SeaGlide/Test/Lessons/Buoyancy/Glider Full of Water 2.jpg

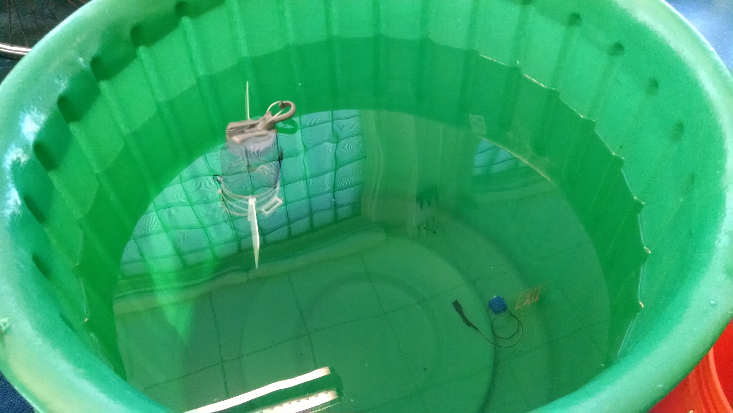
Lessons/Buoyancy/Glider Full of Water 2.jpg
