SeaGlide/Test/Lessons/Buoyancy/Glider Full of Water.jpg

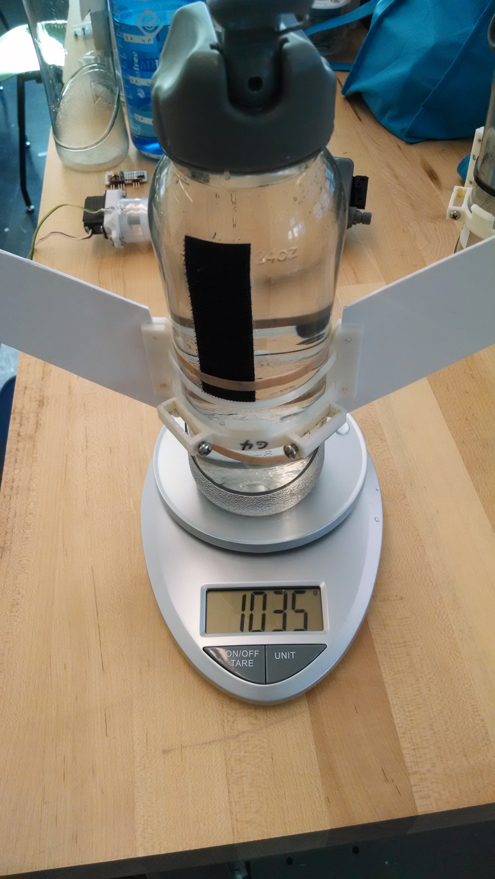
Lessons/Buoyancy/Glider Full of Water.jpg
