SeaGlide/Test/Firmware/Sensor Firmware in : Sensors.rtf

Firmware for sensors pack in / Sensors / ReadTMP102Press6250andWritetoOpenLog
Firmware for sensors attached to glider controller in / Sensors / Sensors in Bottle
