SeaGlide/Test/Firmware/other firmware/Other Firmeares Discription.rtf

SeaGlideV0_9_1
Previous version of the SeaGlide Firmware

SeaGlideV0_9_2
The latest version of the SeaGlide Firmware

SeaGlideV0_9_2Rdr
Variant of 0.9.2 with rudder control via IR Remote. first pause then R & L Arrows move rudder

SeaGlideV0_9_2S
tem102 & Pressure sensors attached and logging data to serial port at regular interval

SimpleGlider2014_IR_mEncoder
2014 SeaGlide firmware with experimental magnetic encoder. borrow code from here to reintegrate magnetic encoder into current version. (it’s not using interrupts, just polling for the pulses)

SimpleGlider2014_IR_mEncoderBB
Breadboard version with different pin assignments
