SeaGlide/Test/Build Instructions/7- Bottle Prep and Ballasting+Wing Design.pdf

# Bottle Prep and Ballasting

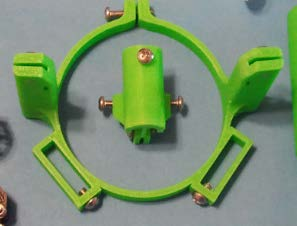
[picture p3: figure]
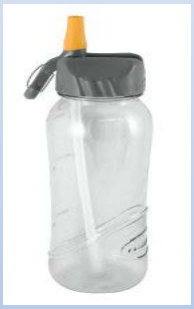
[picture p4: figure]
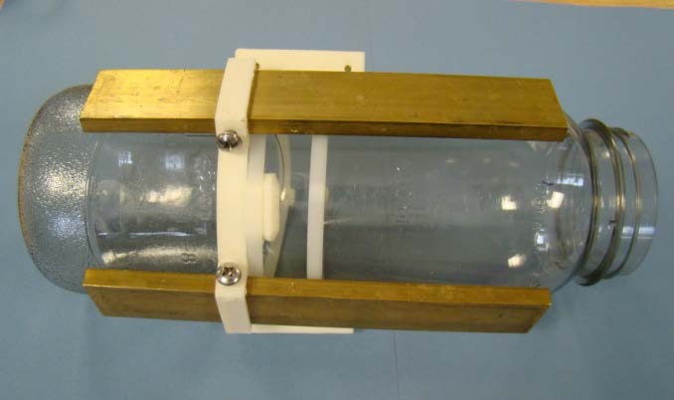
[picture p5: figure]
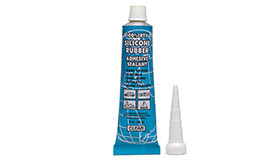
[picture p6: figure]

Parts and supplies include the bottle (1), wing yoke and rudder mount with zip ties (2), brass ballast weights and Dual Lock (3), and silicone sealant (4).

2

3

4

1

## Remove Foam Nozzle and Straws

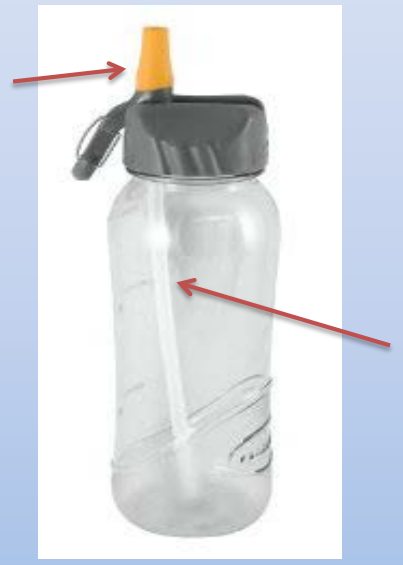
[picture p7: figure]

Remove foam nozzle from cap and plastic straws from inside the bottle.

Foam Nozzle

Plastic Straw

## Prepare Cap for Rudder Mount

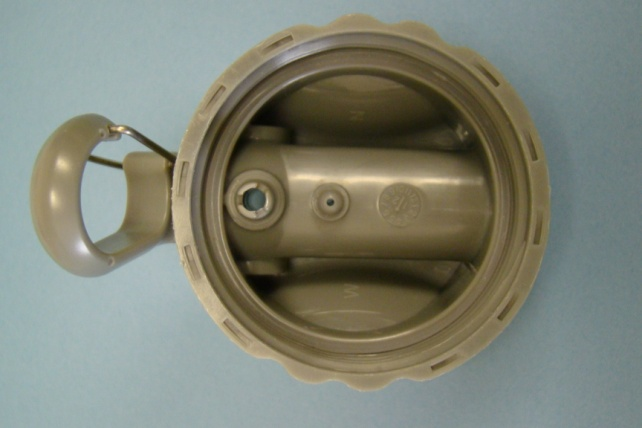
[picture p8: figure]
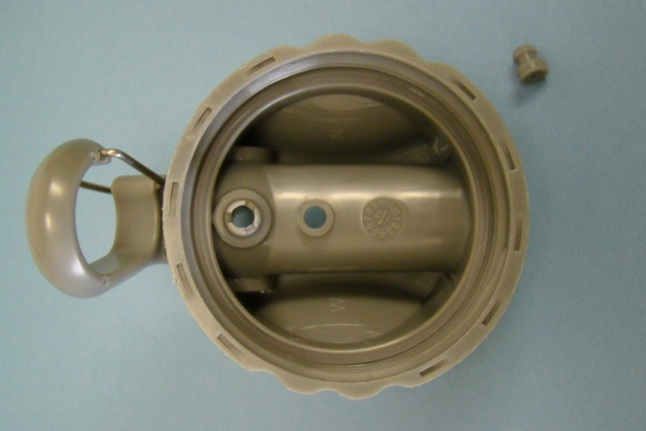
[picture p9: figure]

Remove Air Hole Plug from Cap

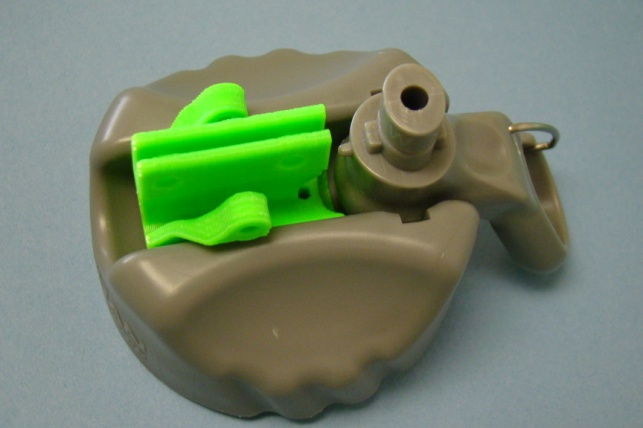
[picture p10: figure]

Test fit rudder mount by aligning screw hole with air hole in cap.

# Secure Rudder Mount

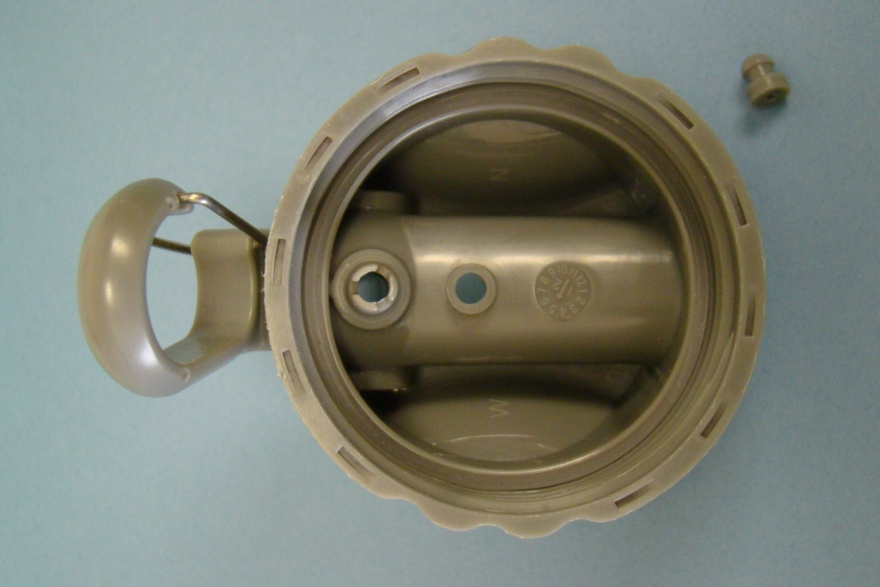
[picture p11: figure]
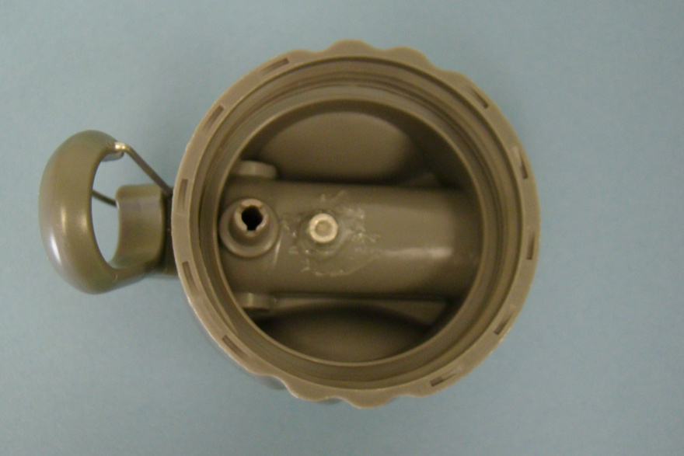
[picture p12: figure]

Apply silicone sealant to air hole opening and drinking spout slot. Position rudder mount and secure from inside with screw provided.

Apply Silicone Sealant | Attach Rudder Mount

# Seal Inside of Cap

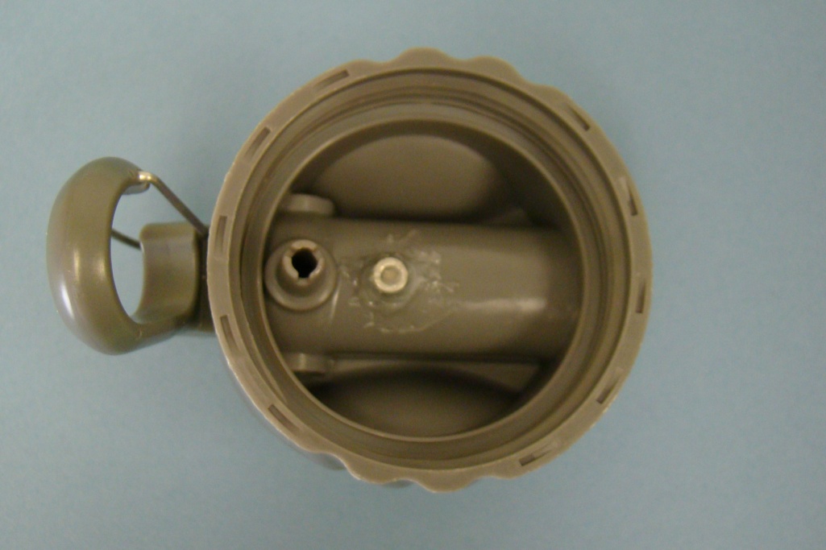
[picture p13: figure]

Apply silicone around and over screw head inside cap to further seal opening and prevent electrical short circuits.

# Attach Wing Yoke

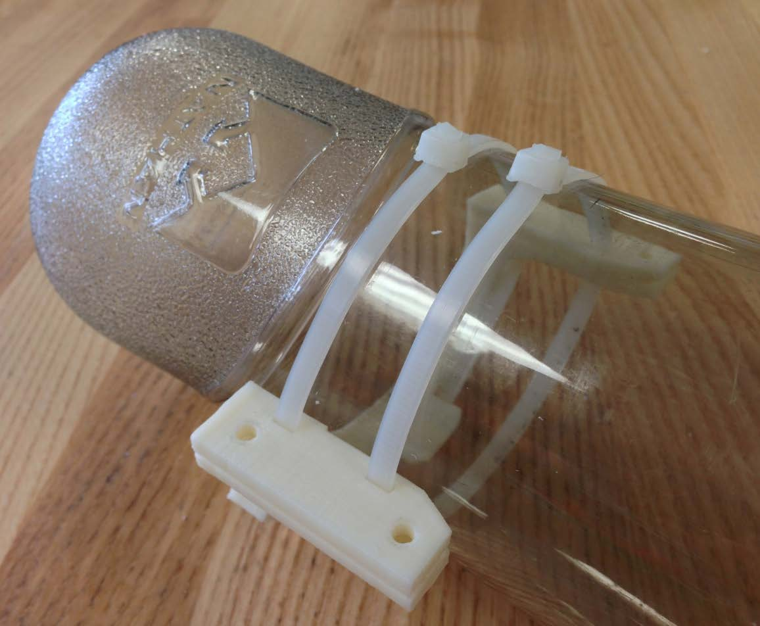
[picture p14: figure]

Position wing yoke on bottle and secure with two zip ties provided.

# Add Ballast to Wing Yoke

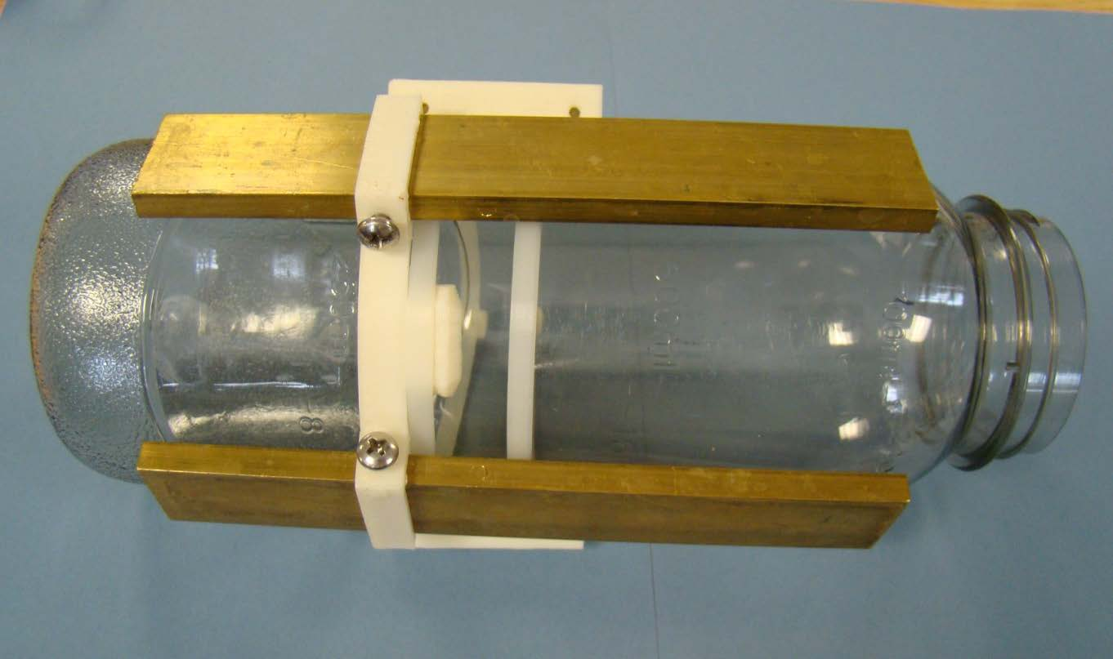
[picture p15: figure]

Slide two 6” bars of brass ballast weight through slots in wing yoke. Secure with screws provided.

# Add Fine Ballast

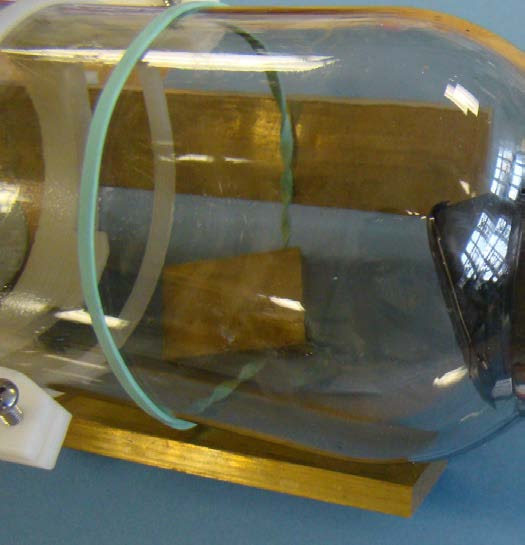
[picture p16: figure]

Stick Dual Lock on bottle between larger brass bars. Apply Dual Lock to a brass weight. This can be positioned anywhere on the bottle’s Dual Lock for finer ballasting.

# Basic Wing Design

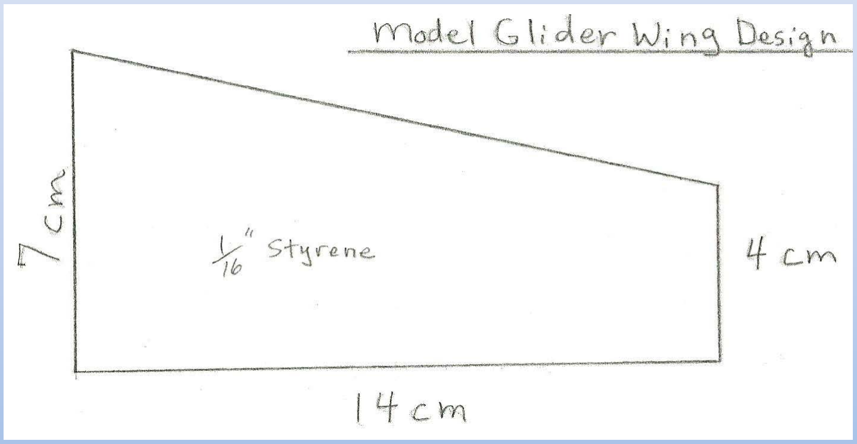
[picture p17: figure]

It’s best to create your own wing design based on research, however this is a basic design that works. You’ll need two wings that can be cut from 1/16th styrene.

# Basic Rudder Design

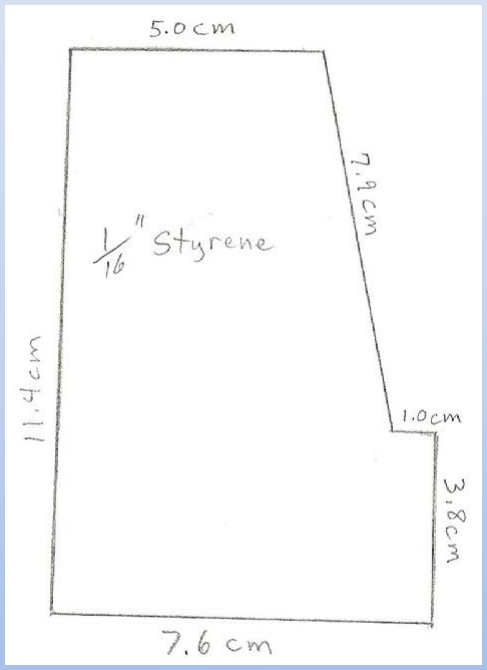
[picture p18: figure]

It’s best to create your own rudder design based on research, however this is a basic design that works. You’ll need one rudder that can be cut from 1/16th styrene.

# Test Fit Wings and Rudder

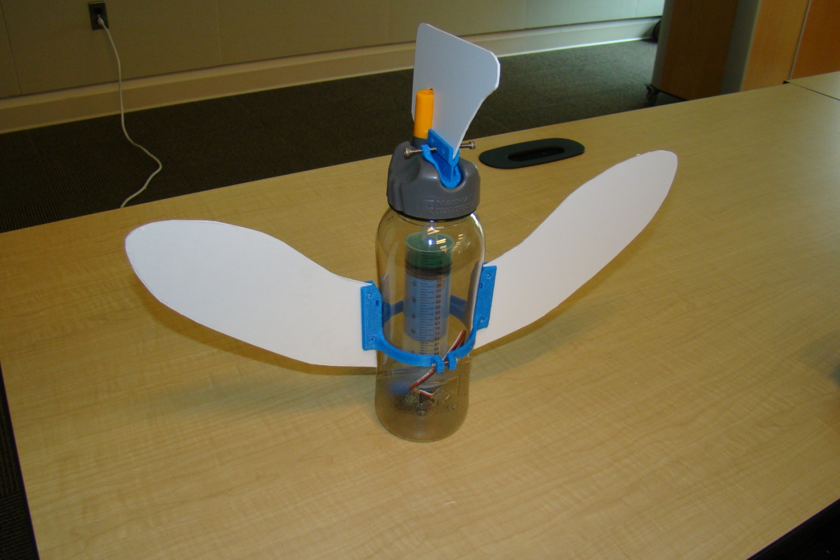
[picture p19: figure]

Fit wings into wing yoke and rudder into rudder mount. Mark drill holes and remove for drilling.

## Drill Wings and Rudder Mounting Holes

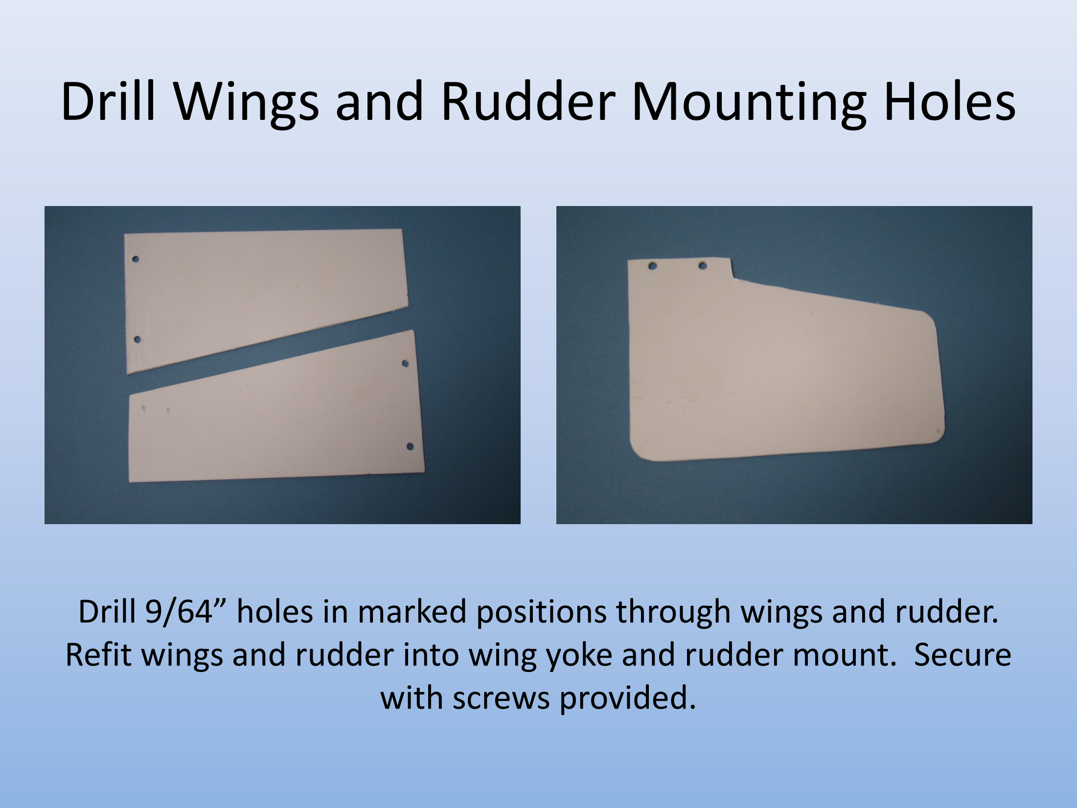
[picture p20: page 12]

Drill 9/64” holes in marked positions through wings and rudder. Refit wings and rudder into wing yoke and rudder mount. Secure with screws provided.
