SeaGlide/Test/Lessons/Arduino lessons/_1.1_TrafficLight/Traffic Light simple.png

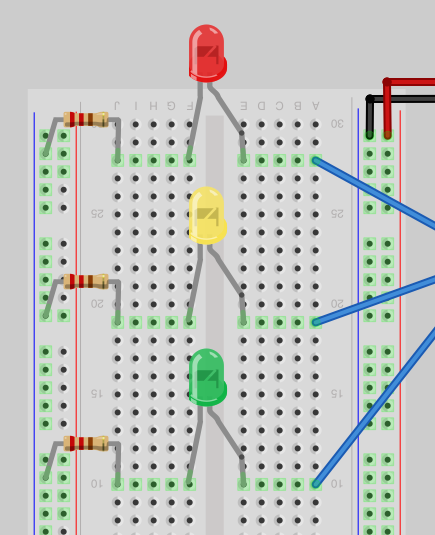
Lessons/Arduino lessons/_1.1_TrafficLight/Traffic Light simple.png
