SeaGlide/Test/Lessons/Arduino lessons/_1.2_TrafficLightWithSensorChallange/Advanced traffic Light challange.png

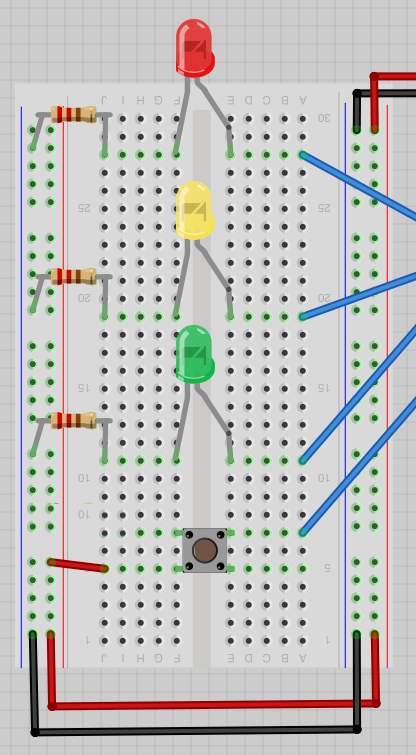
Lessons/Arduino lessons/_1.2_TrafficLightWithSensorChallange/Advanced traffic Light challange.png
