SeaGlide/Test/Lessons/Arduino lessons/_1_Blink/1 blink.png

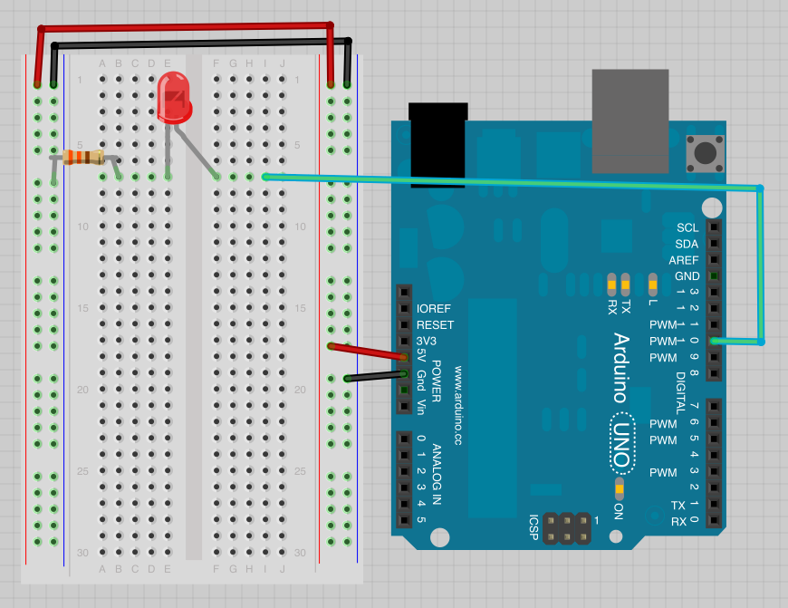
Lessons/Arduino lessons/_1_Blink/1 blink.png
