SeaGlide/Test/Lessons/Arduino lessons/_2.5_potFadeSerialMethod/FlexSensor.png

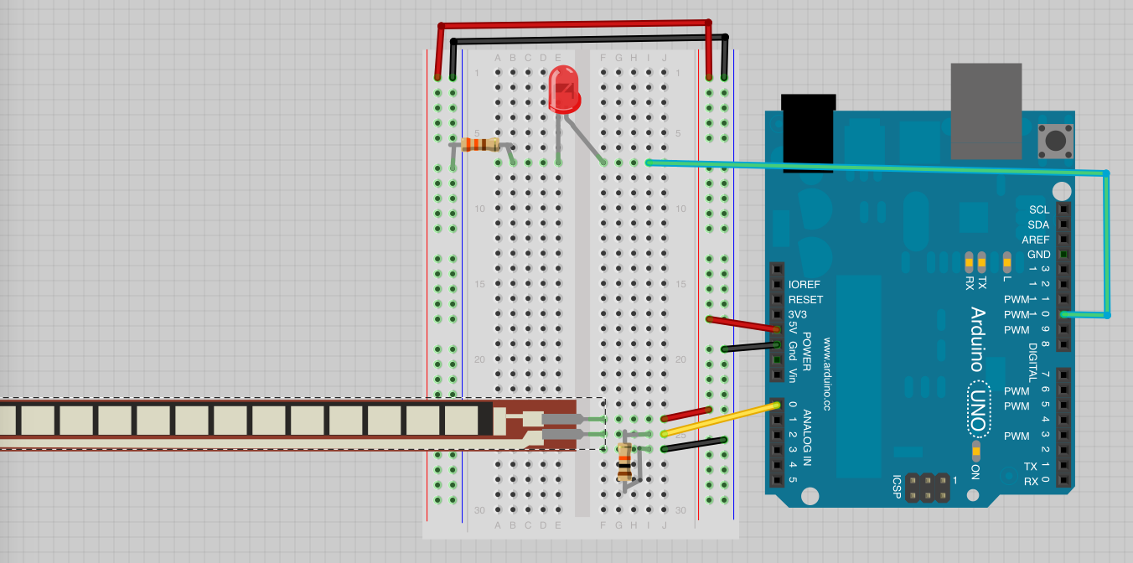
Lessons/Arduino lessons/_2.5_potFadeSerialMethod/FlexSensor.png
