SeaGlide/Test/Lessons/Arduino lessons/_2.5_potFadeSerialMethod/PhotoResistor.png

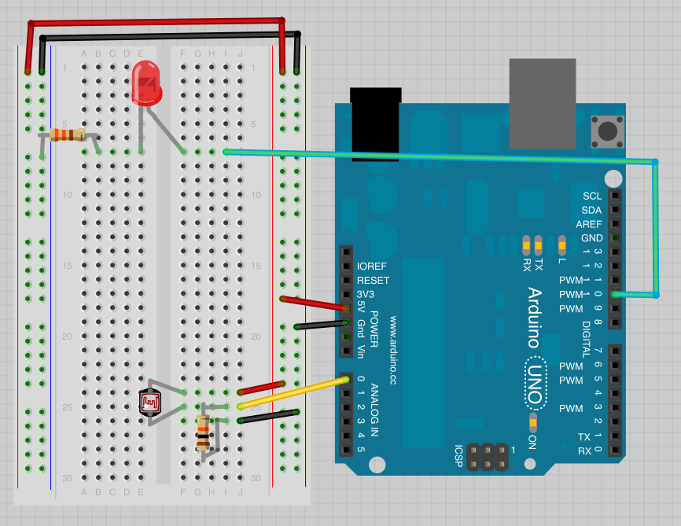
Lessons/Arduino lessons/_2.5_potFadeSerialMethod/PhotoResistor.png
