SeaGlide/Test/Lessons/Arduino lessons/_2_potentiometer/2 Potentiometer.png

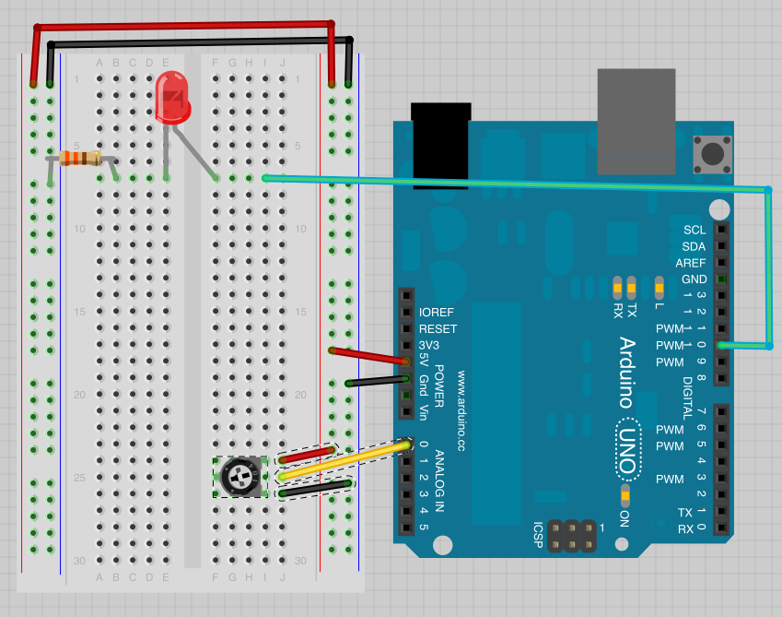
Lessons/Arduino lessons/_2_potentiometer/2 Potentiometer.png
