SeaGlide/Test/Lessons/Arduino lessons/_3_Button/3 button led pullup.png

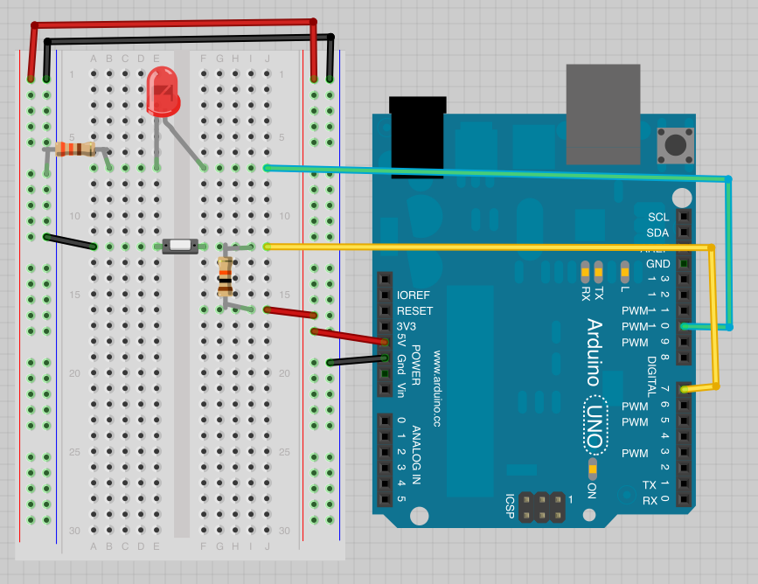
Lessons/Arduino lessons/_3_Button/3 button led pullup.png
