SeaGlide/Test/Lessons/Arduino lessons/_4.1_PotFadeSerialServo/4.1 PotFadeSerialServo.png

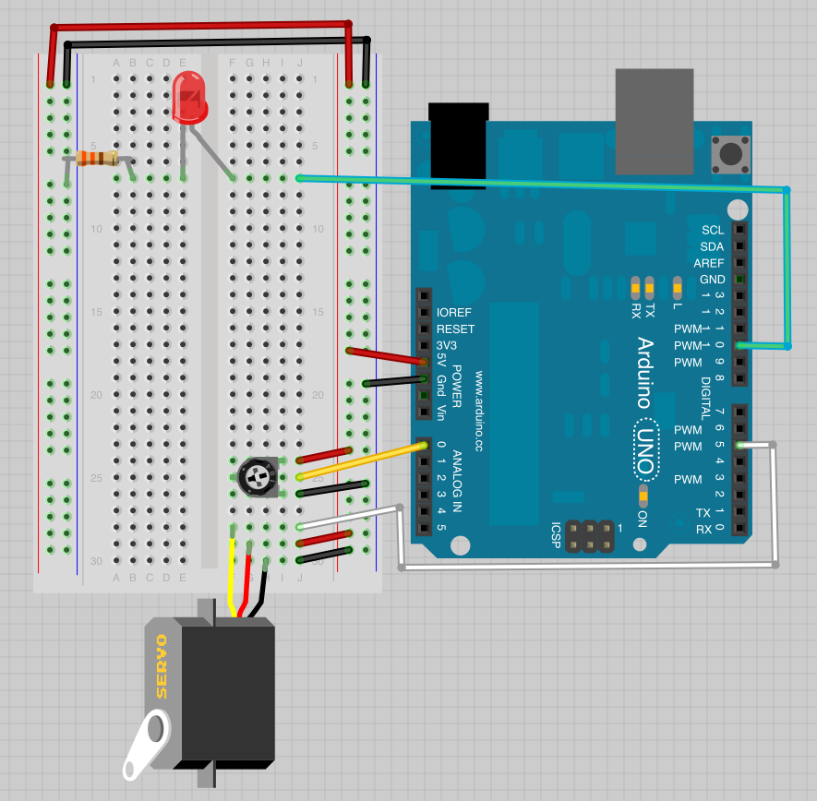
Lessons/Arduino lessons/_4.1_PotFadeSerialServo/4.1 PotFadeSerialServo.png
