SeaGlide/Test/Lessons/Arduino lessons/_4.2_buttons_servo_Continuous/4 buttons servo.png

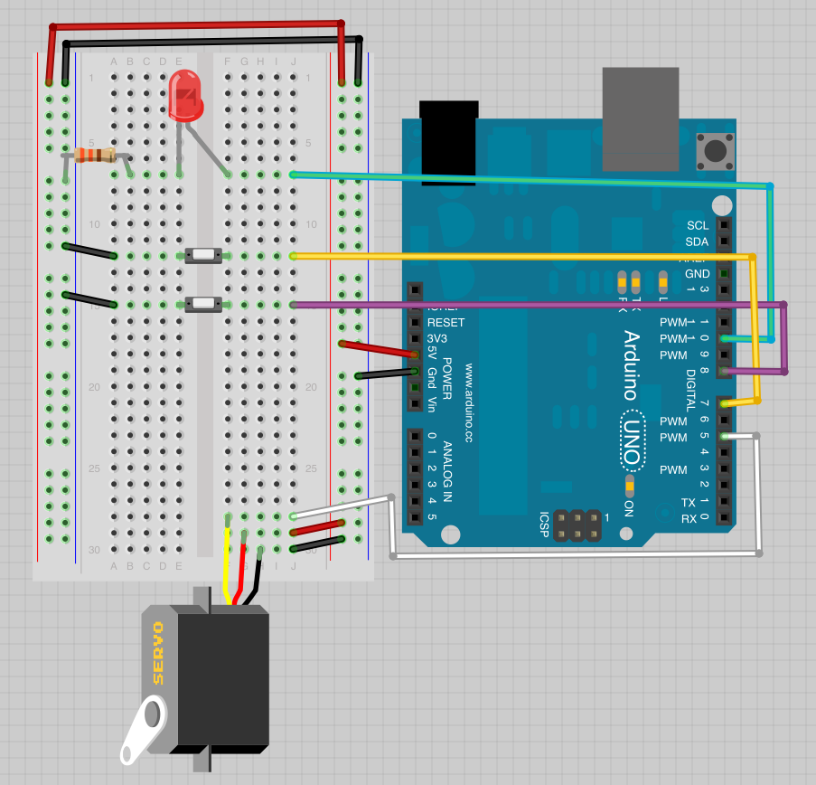
Lessons/Arduino lessons/_4.2_buttons_servo_Continuous/4 buttons servo.png
