SeaGlide/Test/BOM/SeaGlide 1.0 BOM (Kit).xlsx

Item Notes | Item | Function | #/ Glider | #/Pack | packs/glider | Vendor Item # | Vendor | link
Buoyancy Engine/Bottle Prep&Bal | 3D printed plastic parts | Wing Yoke & Rudder Mount, CP, Shaft Coupling, Servo Mount | 1 set | 1 | 1 set | SeaGlide Parts Set from seaGlide.net/resources | $15 Approximate Previous quoted price | from jyapchua@gmail.com
Microcontroller | IR Receiver | Receives signal to position plunger | 1 | 1 | 1 | 157 | ADAFRUIT | http://www.adafruit.com/products/157?&main_page=product_info&cPath=35&products_id=157
Microcontroller | Remote | Remote control of Buoyancy Engine (BE) | 1 | 1 | 1 | 389 | ADAFRUIT | http://www.adafruit.com/product/389
Microcontroller | RGB LED | Dive Cycle Indicator | 1 | 1 | 1 | 302 | ADAFRUIT | http://www.adafruit.com/products/302
Bottle Prep & Ballasting | Nathan 700ml Tritan Bottle with Flip Straw, Grey NO SUBSTITUTES…Link at right is the only approved bottle | Glider Hull | 1 | 1 | 1 | 700 ml | AMAZON | http://www.amazon.com/Nathan-700ml-Tritan-Bottle-Straw/dp/B00198U6TW | OR | 4022TNG 700ML Flipstraw Bottle. 500 units for $3,250 $6.5 each. from Zach Miller: zmiller@nathansports.com t. 800.523.2844 ext 8812 f. 610.534.4424 2009 Elmwood Ave., Sharon Hill, PA 1907
Bottle Prep & Ballasting | 3M Dura-Lock (super Velcro) | Secure Fine Ballast Weights | >=8" | - | - | - | AMAZON | http://www.amazon.com/3M-Reclosable-Fastener-TB3560-Clear/dp/B007OXK1WI
Buoyancy Engine | BBs | Ballast in Cylinder Plunger (CP) | 250g | 20553/pack | 250 grams | - | AMAZON | http://www.amazon.com/Crosman-Copperhead-Copper-Coated-Bottle/dp/B000HKKY7M?s=sporting-goods
Tool | 3/32” drill bit with hex drive shank | used to hand-drill holes in syringe | 1 |  | 1 |  | AMAZON | https://www.amazon.com/dp/B0000225OK/ref=cm_sw_r_awd_5ji-vbQH34ZRW
Tool | Reversable Philips & Flat head pen-sized Screwdriver | philips and flat drivers required. ~2" shank required | 1 |  | 1 |  | AMAZON | http://www.amazon.com/Seismic-Audio-SAPT201-Screwdriver-Repair/dp/B00CTHRH3U | OR | http://www.alibaba.com/product-detail/Pocket-Partner-Reversible-Blade-Screwdriver_60204861192.html
Bottle Prep & Ballasting | 3/4"D x 3/8"H Cylindrical Magnets | Ballast | 8 | 50 | 0.16 |  | AMAZON | http://www.amazon.com/Darice-MM10075-50-Piece-Energy-Magnets/dp/B00P7VUOJ4
Bottle Prep & Ballasting | Marine epoxy single use pack | Waterproof Rudder Mount | 1x single use packet | 1 | 1x single use packet | - | AMAZON | http://www.amazon.com/Hardman-Double-Bubble-Purple-Label-04003/dp/B00K3X2660 (http://www.autohausaz.com/search/product.aspx?partnumber=TG-1&crossref=TG1) | OR | http://www.epoxysupply.com/double-bubble-purple-epoxy-04003/
Power Supply | Li-Ion 9V 500mAh (4.5Wh each) Rechargeable Battery ( UN 38.3 Passed)+ 0.3A Smart Charger (9V Snap-on connector) (0.3) | Power Supply and Charger | 1 | 1 | 1 | Battery + Charger | BATTERYSPACE | http://www.batteryspace.com/li-ion-9v-500mah-4-5wh-each-rechargeable-battery-un-38-3-passed-0-3a-smart-charger-9v-snap-on-connector-0-3.aspx
Power Supply - Extra Battery | Li-Ion 9V 500mAh (4.5Wh) Rechargeable Battery |  | 1 | 1 | 1 | LIR-9V | BATTERYSPACE | http://www.batteryspace.com/Li-Ion-9V-500mAh-4.5Wh-Rechargeable-Battery.aspx
Circuit Board | 2-Pin JST Male RT Angle Brd Connector - CONN HEADER PH SIDE 2POS 2MM | Mounts on Circuit Board | 1 | 1 | 1 | 455-1719-ND | DIGIKEY | http://www.digikey.com/product-detail/en/S2B-PH-K-S(LF)(SN)/455-1719-ND/926626
Circuit Board | 10k trim pot | Mounts on Circuit Board | 1 | 1 | 1 | D4AA14-ND | DIGIKEY | http://www.digikey.com/product-detail/en/bourns-inc/3306F-1-103/3306F-103-ND/84666 (http://www.digikey.com/scripts/DkSearch/dksus.dll?WT.z_header=search_go&lang=en&x=0&y=0&cur=USD)
Circuit Board | 4.7 ohm 0.6W resistor | Mounts on Circuit Board | 1 | 1 | 1 | BC4.70ZCT-ND | DIGIKEY | http://www.digikey.com/product-detail/en/MBB02070C4708FRP00/BC4.70ZCT-ND/2945833
Power Supply | 14 Conductor, 24 AWG (need 8 conductor or more, 20-24 AWG) | Limit Switch & Hall effect sensor to PCB | 14 strands x 10 inches |  | 14 strands x 10 inches | 135-2406-314 | Newark | http://www.newark.com/amphenol-spectra-strip/135-2406-314/ribbon-cable-14cond-300v-per-m/dp/23M8232 (http://www.digikey.com/product-detail/en/3811%2F10%20300/MC010M-50-ND/3878630)
Power Supply | SWITCH PUSHBUTTON SPST 2A 14V | ON/OFF for Power Supply | 1 |  | 1 | 515PB-ND | DIGIKEY | http://www.digikey.com/product-detail/en/40-3979-00/515PB-ND/523397
Buoyancy Engine | EcoPlus - Measure Master Syringe 100CC (740610) | Heart of Buoyancy Engine | 1 | 1 | 1 | 100CC | EAST WEST HYDRO | http://eastwesthydro.com/garden-supplies/measurement-tools/ecoplus/ecoplus-measure-master-syringe-100cc-740610
Power Supply | Battery Snap Safety 6" 26AWG 6 Prong | 9v Connector in Power Supply | 1 | 1 | 1 | 216452 | JAMECO | http://www.jameco.com/webapp/wcs/stores/servlet/Product_10001_10001_216452_-1
Bottle Prep & Ballasting | Easy-to-Machine Polystyrene Sheet, 1/16" Thick, 40" x 72" | Wings and Rudder | 10" x 10" square or 1 ft^2 | 40" x 72" sheet | 0.036 | 8734K22 (http://www.mcmaster.com/) | McMaster | http://www.mcmaster.com/#8734K22
Bottle Prep & Ballasting | Laboratory Clear Tygon PVC Tubing, 5 mm ID, 8 mm OD, 1.5 mm Wall Thickness | Connects Syringe to Bottle Cap Interior Nozzle | 2x >=1.25" | ft | 2x >=1.25" | 5186T14 (http://www.mcmaster.com/) | McMaster | http://www.mcmaster.com/#5186T14
Bottle Prep & Ballasting | Low-Carbon Steel Rectangular Bar, 1/4" Thick, 1" Wide - 1/2 ft. These need to be cut to length, de-burred, and painted with primer | Ballast | 2x 6" & 1x 2.75" +/- 1/8" for lengths | ft | 2x 6" & 1x 2.5" +/- 1/8" for lengths | 8910K383 | McMaster | http://www.mcmaster.com/#8910K383
Bottle Prep & Ballasting | Small zip ties | Secures Tubing to Cap Nozzle and Syringe | 4 | 1 | 4 | 6705K31 (http://www.mcmaster.com/) | McMaster | http://www.mcmaster.com/#6705K31
Bottle Prep & Ballasting | Large zip ties | Secure wing yoke to bottle & Create tether Loop | 8 | 1 | 8 | 7130K56 (http://www.mcmaster.com/) | McMaster | http://www.mcmaster.com/#7130K56
Buoyancy Engine | 18-8 Stainless Steel Hex Head Cap Screw | Lead Screw | 1 | 1 | 1 | 92240A932 (http://www.mcmaster.com/) | McMASTER | http://www.mcmaster.com/#92240A932
Buoyancy Engine | Brass 6/16-18 nuts (jam nuts, thin) | For Drive Screw | 1 | 1 | 1 | 92174A030 (http://www.mcmaster.com/) | McMaster | http://www.mcmaster.com/#92174A030
Buoyancy Engine | 3/8" ID 1" OD washer Stainless | Seals Cylinder Plunger (CP) | 1 | 1 | 1 | 92141A051 | McMaster | http://www.mcmaster.com/#92141A051
Buoyancy Engine | Flat Head Phillips Screw for Sheet Metal #2 x3/8 | Connects Washer to CP, Shaft Coupling together, Syringe to Servo Mount | 14 | 1 | 14 | 90065A079 | McMaster | http://www.mcmaster.com/#90065a079/=snxfsx
Buoyancy Engine | #4 washer | Shaft Coupling to Servo Horn | 12 | 1 | 12 | 98019A309 (http://www.mcmaster.com/) | McMaster | http://www.mcmaster.com/#98019A309
Buoyancy Engine/Bottle Prep&Bal | #6 1/2" Thread-Cutting Screws | Attaches Servo and Wings & Rudder | 18 | 1 | 18 | 94629A680 | McMaster | http://www.mcmaster.com/#94629A680
Power Supply/ Circuit Board | Heat-Shrink Tubing, 1/8" ID Before, 1/16" ID After | Protects wire joints | 6 | ft | 6" | 7856K13 (http://www.mcmaster.com/) | McMaster | http://www.mcmaster.com/7856K133
Power Supply | Tactile Switch w/ long stem | Limit Switch for BE | 1 | 1 | 1.00 | 688-SKRGALD010 | MOUSER | http://www.mouser.com/ProductDetail/ALPS/SKRGALD010/
Circuit Board | SeaGlide PCB | Circuit Board | 1 | 1 | 1.00 | SeaGlide | OSHPARK | https://oshpark.com/profiles/MBC (https://oshpark.com/profiles/SeaGlide)
Power Supply | 2-Pin Female JST PH-Style Cable (14cm) (https://www.pololu.com/product/1116) | Power Supply to Circuit Board | 1 | 1 | 1.00 | 1116 | POLOLU | http://www.pololu.com/product/1116
Buoyancy Engine | Servo - Generec Continuous Rotation (SM-S3317S) Data sheet attached | Drives Lead Screw | 1 | 1 | 1.00 | 10189 | SPARKFUN | https://www.sparkfun.com/products/10189
Circuit Board/Microcontroller | Male Header rt angle 0.1 pitch (24 pin) | Connects Arduino to FTDI Bd | 1 | 1 | 1.00 | 553 | SPARKFUN | https://www.sparkfun.com/products/553
Microcontroller | FTDI Basic Breakout - 5V | Computer Interface | 1 | 1 | 1.00 | 9716 | SPARKFUN | https://www.sparkfun.com/products/9716
Microcontroller | Arduino pro mini 328 - 5V 16MHz | Microcontroller | 1 | 1 | 1.00 | 11113 | SPARKFUN | https://www.sparkfun.com/products/11113
Microcontroller | 6 Pin Right Angle Female Header | Connects Arduino to Circuit Bd | 2 | 1 | 2.00 | 9429 | SPARKFUN | https://www.sparkfun.com/products/9429
Microcontroller | Socket Pins | Attachment for LED and IR Rec | 8 | 30 | 0.27 | 743 | SPARKFUN | https://www.sparkfun.com/products/743
Tool | Latex free disposible gloves, Medium | protect hands when applying epoxy | 2 | 100 | 0.02 | - | AMAZON | http://www.amazon.com/SafeTouch-Nitrile-Gloves-Latex-Powder/dp/B000OFKDXA
Tool | Silicone grease packet | lubricate drive screw | 1 | 1 | 1 | - | Wallmart | http://www.walmart.com/ip/SUPER-LUBE-82340-Multi-Purpose-Grease-Packet-1cc-G2272448/50709113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
Tool | pushpin | puncture pilot holes in syringe | 4 | 200 | 0.02 | - | AMAZON | http://www.amazon.com/Officemate-Push-Clear-Count-35711/dp/B002WN32YE
