SeaGlide/Test/BOM/SeaGlide 1.0 BOM.xlsx

Sheet: Core Seaglide BOM
SeaGlide Bill of Materials |  |  |  |  |  |  |  | total | $94.20 |  | http://www.mcmaster.com/#
Item Notes | Item | #/Glider |  | #/pack | Item # |  | #/ glider | price | Price/ glider |  | link
 | drive bolt | 1 |  | 10 | 92240A932 (http://www.mcmaster.com/) |  | 0.10 | $5.44 | $0.54 |  | http://www.mcmaster.com/#92240A932
 | pollystyrine sheet 1/16" | 10"x10" |  | 40x72 | 8734K22 (http://www.mcmaster.com/) |  | 0.06 | $29.03 | $1.61 |  | http://www.mcmaster.com/#8734K22
 | tygon tubing | 1.5 | in | 12 | 5186T14 (http://www.mcmaster.com/) |  | 0.12 | $1.77 | $0.22 |  | http://www.mcmaster.com/#5186T14
 | Steel Bar 1/4"x1"x6" need 2x6" + 1x 2.75" | 2.5 |  | 1 | 8910K383 |  | 2.50 | $2.77 | $6.92 |  | http://www.mcmaster.com/#8910K383
 | small zip ties | 4 |  | 100 | 6705K31 (http://www.mcmaster.com/) |  | 0.04 | $7.12 | $0.28 |  | http://www.mcmaster.com/#6705K31
 | large zip tie | 8 |  | 100 | 7130K56 (http://www.mcmaster.com/) | 10 | 0.08 | $14.75 | $1.18 |  | http://www.mcmaster.com/#7130K56
 | Brass 6/16-18 nuts (jam nuts, thin) | 1 |  | 25 | 92174A030 (http://www.mcmaster.com/) |  | 0.04 | $6.44 | $0.26 |  | http://www.mcmaster.com/#92174A030
 | 3/8" ID 1" OD washer Stainless | 1 |  | 100 | 92141A051 |  | 0.01 | $7.66 | $0.08 |  | http://www.mcmaster.com/#92141A051
 | #6 1/2" Thread-Cutting Screws | 12 |  | 100 | 94629A680 |  | 0.12 | $5.59 | $0.67 |  | http://www.mcmaster.com/#94629A680
 | #2 x3/8 Sheet Metal Stainless | 10 |  | 100 | 90065A079 |  | 0.10 | $3.10 | $0.31 |  | http://www.mcmaster.com/#90065a079/=snxfsx
 | Heat Shrink Tubing 1/8-1/16 ID | 4 | in | 48 | 7856K133 (http://www.mcmaster.com/) |  | 0.08 | $1.82 | $0.15 |  | http://www.mcmaster.com/#7856K133
 | 3M Dura-Lock (Industrial Velcro) | 8 | in | 120 |  |  | 0.07 | $27.70 | $1.85 |  | http://www.amazon.com/3M-Reclosable-Fastener-TB3560-Clear/dp/B007OXK1WI
 | Marine epoxy | 1 |  | 8 |  |  | 0.12 | $5 | $0.62 |  | http://www.amazon.com/Loctite-Marine-0-85-Fluid-Syringe-1405604/dp/B00KH62K50 |  | OR single use packs |  | http://www.amazon.com/Hardman-Double-Bubble-Purple-Label-04003/dp/B00K3X2660 (http://www.autohausaz.com/search/product.aspx?partnumber=TG-1&crossref=TG1) |  | OR | http://www.epoxysupply.com/double-bubble-purple-epoxy-04003/
 | BBs | 250 | g | 2053 |  |  | 0.12 | $10.99 | $1.34 |  | http://www.amazon.com/Crosman-Copperhead-Copper-Coated-Bottle/dp/B000HKKY7M?s=sporting-goods
 | 9v Li-Ion Rechargeable battery, EBL 600mAh Li-ion 9V | 1 |  | 4 |  |  | 0.25 | 19.99 | $5.00 |  | http://www.amazon.com/dp/B00GLLZJ44/ref=twister_B00KW3O15A?_encoding=UTF8&psc=1
 | 9v charger | 1 |  | 1 |  |  | 1 | 7.99 | $7.99 |  | http://www.amazon.com/dp/B00EB3YEEU/ref=twister_B00KW3O15A?_encoding=UTF8&psc=1
 | 3D printed plastic parts | 1 |  |  |  |  |  |  | $15.00 | est |  | jyapchua@gmail.com |  | or from someone on http://www.makexyz.com/
 | 2 pin JST Male with pigtail | 1 |  | 100 | 1116 |  | 0.01 | $60.00 | $0.60 |  | http://www.pololu.com/product/1116 |  |  |  |  |  |  | x
 | 14 Conductor, 24 AWG (need 8 conductor or more, 20-24 AWG) 14 strands x 10 inches | 1 | ft | 3 | 135-2406-314 |  | 0.33 | $3 | $1.00 |  | http://www.newark.com/amphenol-spectra-strip/135-2406-314/ribbon-cable-14cond-300v-per-m/dp/23M8232 (http://www.digikey.com/product-detail/en/3811%2F10%20300/MC010M-50-ND/3878630)
 | Tactile Switch w/ long stem | 1 |  | 100 | 688-SKRGALD010 | $0.26 | 0.01 | $19.70 | $0.20 |  | http://www.mouser.com/ProductDetail/ALPS/SKRGALD010/
 | 9V Battery Clip | 216452 | 1 | 0 | $0.32 | $0.00 |  | 1 | $0.35 |  | http://www.jameco.com/webapp/wcs/stores/servlet/Product_10001_10001_216452_-1
 | 2 pin JST female rt angle brd connector | 1 |  | 100 | 455-1719-ND | $0.09 | 0.01 | $9.44 | $0.09 |  | http://www.digikey.com/product-detail/en/S2B-PH-K-S(LF)(SN)/455-1719-ND/926626
 | 10k trim pot | 1 |  | 10 | D4AA14-ND | $0.40 | 0.10 | $4.00 | $0.40 |  | http://www.digikey.com/product-detail/en/bourns-inc/3306F-1-103/3306F-103-ND/84666
 | 4.7 ohm 0.6W resistor | 1 |  | 100 | BC4.70ZCT-ND | 0.1924 | 0.01 | $19.24 | $0.19 |  | http://www.digikey.com/product-detail/en/MBB02070C4708FRP00/BC4.70ZCT-ND/2945833
 | push push power switch | 1 |  | 50 | 515PB-ND | 1.478 | 0.02 | $73.90 | $1.50 |  | http://www.digikey.com/product-detail/en/40-3979-00/515PB-ND/523397
 |  |  |  |  |  |  |  |  |  |  | https://www.sparkfun.com/products/
 | FTDI Basic Breakout - 5V | 1 |  | 100 | 9716 |  | 0.01 | $1196.00 | $11.96 |  | https://www.sparkfun.com/products/9716 |  |  |  |  | chip costs $4 make our own board -$5 |  | 5
 | Arduino pro mini 328 - 5V 16MHz | 1 |  | 100 | 11113 |  | 0.01 | $796.00 | $7.96 |  | https://www.sparkfun.com/products/11113
 | Servo - Medium Full Rotation | 1 |  | 100 | 10189 |  | 0.01 | $956.00 | $9.56 |  | https://www.sparkfun.com/products/10189
 | 6 Pin Right Angle Female Header | 2 |  | 100 | 9429 |  | 0.02 | $76.00 | $1.52 |  | https://www.sparkfun.com/products/9429 |  |  |  |  | save by buying from DigiKey |  | 0.5
 | male header rt angle 0.1 pitch (24 pin) | 0.5 |  | 100 | 553 |  | 0.01 | $176.00 | $0.88 |  | https://www.sparkfun.com/products/553 |  |  |  |  | save by buying from DigiKey |  | 0.5
 | socket pins | 8 |  | 300 | 743 |  | 0.03 | $35.60 | $0.95 |  | https://www.sparkfun.com/products/743
 | IR reciever | 1 | 50 | 50 | 157 |  | 0.02 | $73.00 | $1.46 |  | http://www.adafruit.com/products/157?&main_page=product_info&cPath=35&products_id=157
 | remote | 1 | 10 | 1 | 389 |  | 1.00 | $4.46 | $4.46 |  | http://www.adafruit.com/product/389
 | RGB LED | 1 |  | 20 | 302 |  | 0.05 | $16.00 | $0.80 |  | http://www.adafruit.com/products/302
custom PCB | SeaGlide PCB | 1 |  | 3 | SeaGlide |  | 0.33 | $7.95 | $2.65 |  | https://oshpark.com/profiles/MBC
 | Nathan Water Bottle | 1 |  | 1 | 700 ml |  | 1 | $6.50 |  | Bulk rate, direct from Nathan |  |  |  | http://www.amazon.com/Nathan-700ml-Tritan-Bottle-Straw/dp/B00198U6TW?s=sporting-goods
 |  |  |  |  |  |  |  | $11.99 | $11.99 |  | http://www.amazon.com/Nathan-700ml-Tritan-Bottle-Straw/dp/B00198U6TW |  |  | get the black color option, best stock & price & performance
 | 100 cc syringe | 1 |  | 1 | 100CC |  | 1 | $4.29 | $3.73 |  | http://eastwesthydro.com/garden-supplies/measurement-tools/ecoplus/ecoplus-measure-master-syringe-100cc-740610 |  |  |  |  | Should be able to reduce by $3+ by buying in bulk |  | 3
 |  |  |  |  |  |  |  |  | $94.20 | Glider Total |  | In large quantities (>50) before shipping |  |  |  |  |  | $85.20
Extras
 | Rubber bands
 | Ballast washers
 | electrical tape
 | pushpins, puncture pilot holes in syringe |  |  |  |  |  |  |  |  |  | http://www.amazon.com/Officemate-Push-Clear-Count-35711/dp/B002WN32YE
 | Latex free disposible gloves, Medium |  |  |  |  |  |  |  |  |  | http://www.amazon.com/SafeTouch-Nitrile-Gloves-Latex-Powder/dp/B000OFKDXA
 | Hot melt glue
 | 3/32” drill bit with hex drive shank |  |  |  |  |  |  |  |  |  | https://www.amazon.com/dp/B0000225OK/ref=cm_sw_r_awd_5ji-vbQH34ZRW
 | Reversable Philips & Flat head pen-sized Screwdriver |  |  |  |  |  |  |  |  |  | http://www.amazon.com/Seismic-Audio-SAPT201-Screwdriver-Repair/dp/B00CTHRH3U
 | Silicone grease packet lubricate drive screw | 1 |  | 1 | 0 |  | 1.00 | 0.79 | $0.79 |  | http://www.walmart.com/ip/SUPER-LUBE-82340-Multi-Purpose-Grease-Packet-1cc-G2272448/50709113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
 | or use 3 in one oil

Sheet: Sensor pack & extras
Sensor module Bill of Materials
 | UCO Matchstick Case | 1 |  | 1 |  |  | 1 | $2.49 | $2.49 |  | http://www.sunnysports.com/prod/UCOMC.html |  |  | x
 | Arduino pro mini 328 - 5V 16MHz | 1 |  | 100 | 11113 |  | 0.01 | $796.00 | $7.96 |  | http://www.amazon.com/gp/product/104800001X/ref=oh_aui_detailpage_o03_s00?ie=UTF8&psc=111113 |  |  | 2
 | open log | 1 |  | 1 | 9530 |  | 1 | $19.96 | $19.96 |  | http://www.amazon.com/gp/product/104800001X/ref=oh_aui_detailpage_o03_s00?ie=UTF8&psc=19530 |  |  | 15
 | tmp 102 temp sensor | 1 |  | 1 | 9418 |  | 1 | $4.76 | $4.76 |  | http://www.amazon.com/gp/product/104800001X/ref=oh_aui_detailpage_o03_s00?ie=UTF8&psc=19418 |  |  | 2
 | 6 Pin Right Angle Female Header | 1 |  | 1 | 9429 |  | 1 | $0.76 | $0.76 |  | http://www.amazon.com/gp/product/104800001X/ref=oh_aui_detailpage_o03_s00?ie=UTF8&psc=19429 |  |  | 0.5
new, option | 100 ft pressure sensor | 1 |  | MPXHZ6400AC6T1 | MPXHZ6400AC6T1CT-ND |  |  | 10.72 | 8.6175 |  | http://www.digikey.com/product-detail/en/MPXHZ6400AC6T1/MPXHZ6400AC6T1CT-ND/2057456 |  | Freescale Semiconductor
 | Cermaic Disk Capacitor - 47 pF | 1 |  | 1 | 445-4722-ND | $0.10 | 1 | $0.10 | $0.10 |  | http://www.digikey.com/scripts/dksearch/dksus.dll?vendor=0&keywords=445-4722-ND
 | Resistor - 51 K Ohms 1/8W 5% Carbon Film | 1 |  | 1 | CF18JT51K0T-ND | $0.02 | 1 | $0.02 | $0.02 |  | http://www.digikey.com/product-detail/en/CF18JT51K0/CF18JT51K0CT-ND/2022783
 | 10-strand ribin cable | 0.5 | ft | 50 | MC010M-50-ND |  | 0.01 | $23.59 | $0.24 |  | http://www.digikey.com/product-detail/en/3811%2F10%20300/MC010M-50-ND/3878630
too thin | ~~4-Conductor 32-AWG cable~~ | ~~1~~ | ~~ft~~ | ~~98~~ | ~~T3017-30-ND~~ |  | ~~0.01~~ | ~~$48.68~~ | ~~$0.50~~ |  | ~~http://www.digikey.com/product-detail/en/30-00217/T3017-30-ND/4368769~~
 | 2x AAA Battery Holder | 1 |  | 140 | BH2AAA-W-ND | $1.41 | 0.01 | $197.40 | $1.41 |  | http://www.digikey.com/product-detail/en/BH2AAAW/BH2AAA-W-ND/32052
 | MicroSD Memory Card 2GB | 1 |  | 1 | 102 |  | 1 | $6.36 | $6.36 |  | http://www.adafruit.com/products/102 |  |  | 4.5
 | Perma Proto PCBs | 0.5 |  | 3 | 589 |  | 0.17 | $8.06 | $1.34 |  | https://www.adafruit.com/products/589
 | SOIC-8 Breakout PCB (pressure sensor) | 6 |  | 1 | 1212 |  | 0.17 | $4.46 | $0.74 |  | https://www.adafruit.com/products/1212
 | pololu step up 5v regulator | 1 |  | 10 | 798 |  | 0.10 | $44.50 | $4.45 |  | http://www.pololu.com/product/798
 | SPDT power switch | 1 |  | 30 | 1408 | $402.00 | 0.03 | $13.40 | $0.45 |  | http://www.pololu.com/catalog/product/1408
 | Heat Shrink Tubing 1/8-1/16 ID | 4 | in | 48 | 7856K133 (http://www.mcmaster.com/) |  | 0.08 | $1.82 | $0.15 |  | 7856K133
 | Marine Epoxy |  |  |  |  |  |  | $6.12 |  |  | http://www.amazon.com/Loctite-1405604-0-85-Ounce-Plastic-Syringe/dp/B000H6A3D6
 | Twist tie |  |  |  |  |  |  |  |  |  |  |  |  | 0.4
 |  |  |  |  |  |  |  |  |  |  |  |  |  | $35.91
 |  |  |  |  |  |  |  |  | $60.31 | Sensor Pack Total |  | This should be a high estimate, it is bassed on rates from retail / low volume suppliers
In Future Versions
 | hall effect sensor |  |  |  |  |  |  | 1.75 | 1.56 |  | http://www.digikey.com/product-search/en?vendor=0&keywords=OH090U
 | hall effect sensor melexis |  |  |  |  |  |  | 2.58 | 2 |  | http://www.digikey.com/product-detail/en/MLX90217LUA-CAA-000-BU/MLX90217LUA-CAA-000-BU-ND/431845
 | Neodinium magnate 1/8"ø x 1/16"L Cylindrical | 8 |  | 100 |  |  | 0.08 | $8.99 | $0.72 |  | http://www.amazon.com/gp/product/104800001X/ref=oh_aui_detailpage_o03_s00?ie=UTF8&psc=1
Old stuff
 | Pressure Gauge, 3-36 psia | 1 |  | 1 | MPXHZ6250AC6T1CT-ND | $9.00 | 1 | $9.00 | $9.00 |  | http://www.digikey.com/product-detail/en/MPXHZ6250AC6T1/MPXHZ6250AC6T1CT-ND/2057455
