SeaGlide/Test/Printed Parts/Core Glider parts/servoMnt BtnHall3.STL

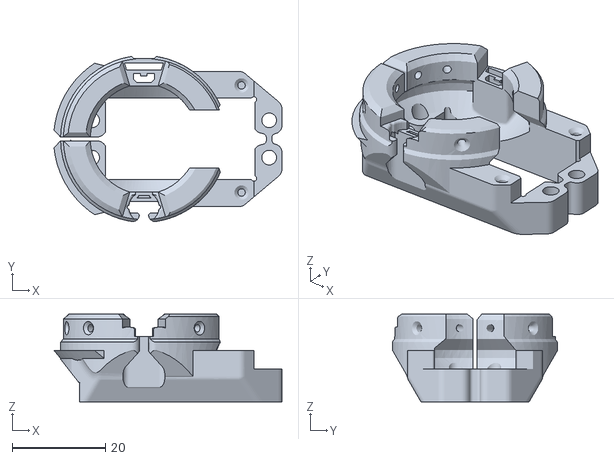
[picture p44: CAD file, 2016-08-29]
Printed Parts/Core Glider parts/servoMnt BtnHall3.STL
48.9 x 35.4 x 18.8
