SeaGlide/Test/Printed Parts/NoseCone/noseCone75extended_JCY_25MAY2015.STL

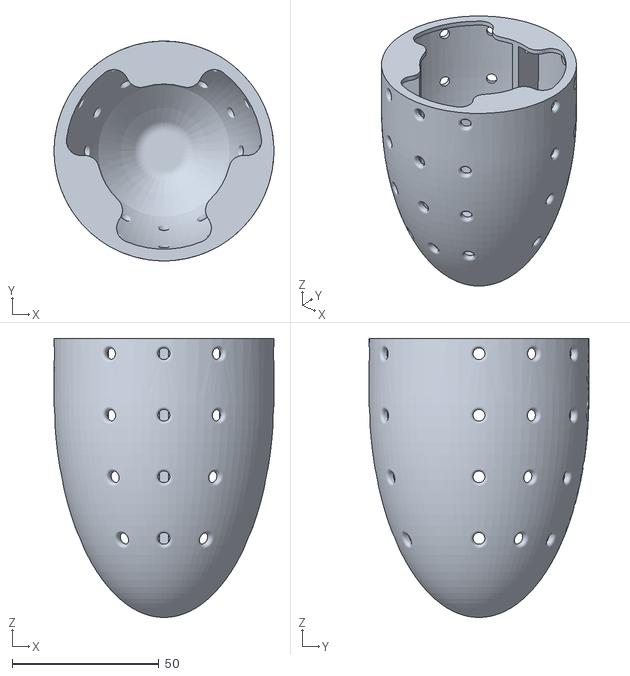
[picture p45: CAD file, 2016-08-29]
Printed Parts/NoseCone/noseCone75extended_JCY_25MAY2015.STL
75.0 x 75.0 x 95.2
