SeaGlide/Test/Printed Parts/Core Glider parts/shaftCouplingH2_17.STL

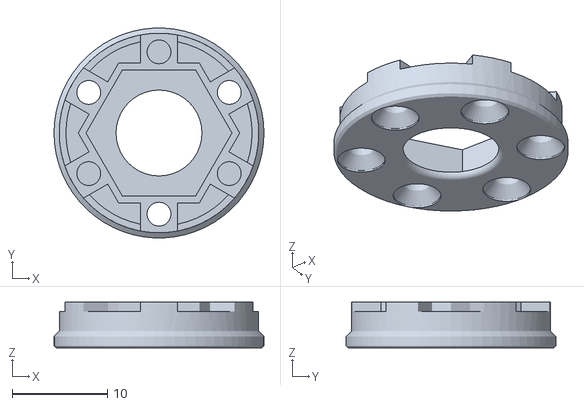
[picture p46: CAD file, 2016-08-29]
Printed Parts/Core Glider parts/shaftCouplingH2_17.STL
22.0 x 22.0 x 4.80
