SeaGlide/Test/Printed Parts/Core Glider parts/rudderMount8.STL

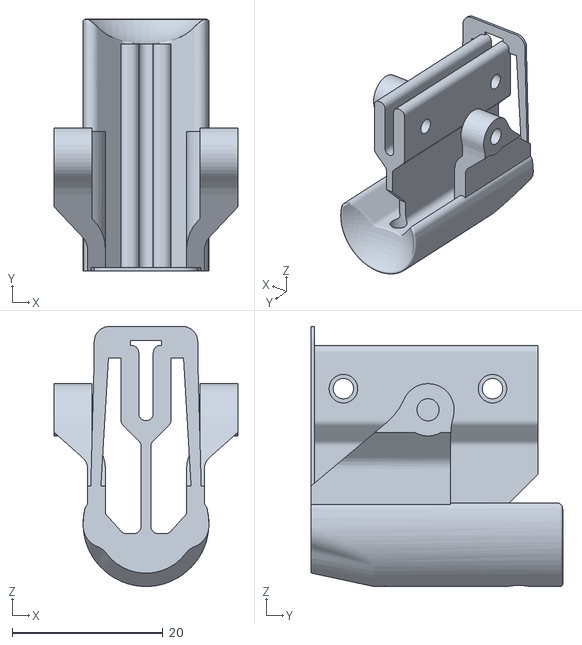
[picture p47: CAD file, 2016-08-29]
Printed Parts/Core Glider parts/rudderMount8.STL
24.4 x 33.4 x 34.5
