SeaGlide/Test/Printed Parts/Core Glider parts/shaftCouplingServoHorn_25.STL

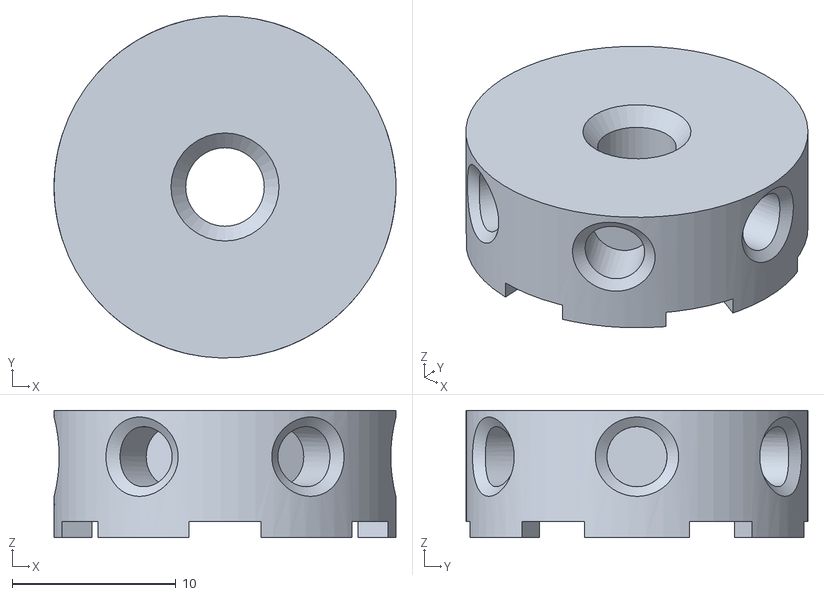
[picture p48: CAD file, 2016-08-29]
Printed Parts/Core Glider parts/shaftCouplingServoHorn_25.STL
20.9 x 20.9 x 7.79
