SeaGlide/Test/Printed Parts/Core Glider parts/wingYoke5_selfTap.STL

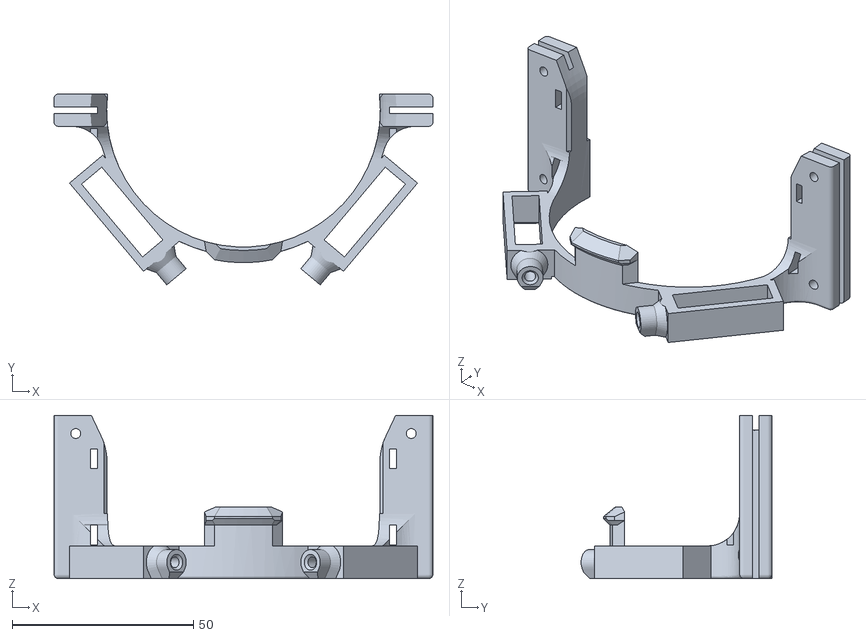
[picture p49: CAD file, 2016-08-29]
Printed Parts/Core Glider parts/wingYoke5_selfTap.STL
104.5 x 52.6 x 45.0
