SeaGlide/Test/Printed Parts/Core Glider parts/plungerCylinder9.1_75mm.STL

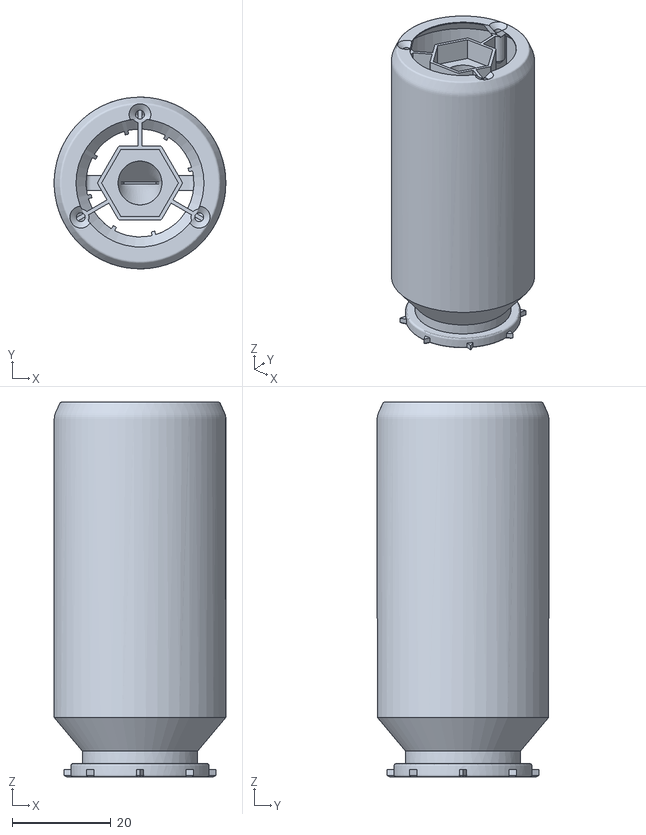
[picture p50: CAD file, 2016-08-29]
Printed Parts/Core Glider parts/plungerCylinder9.1_75mm.STL
34.8 x 34.8 x 76.0
