SeaGlide/Test/(list of files, cad)

Other CAD files:
Printed Parts/Old Parts/plungerMass8_75mm.STL
