SeaGlide/Test/Firmware/IRremote Library Install Instructions.rtf

IRremote Library Install Instructions:

1. Copy IRremote folder into Arduino Library folder
2. Restart Arduino IDE
