SeaGlide/Test/Build Instructions/2- Power Supply Build & Limit Switch.pdf

## Power Supply

The power supply provides 9 volts of direct current to the buoyancy engine controller where the voltage is reduced to approximately 7 volts by a resistor. The power supply includes a snap connector, a 9 volt rechargeable Lithium
battery, and a push button switch which is the ON/OFF control for the circuit.

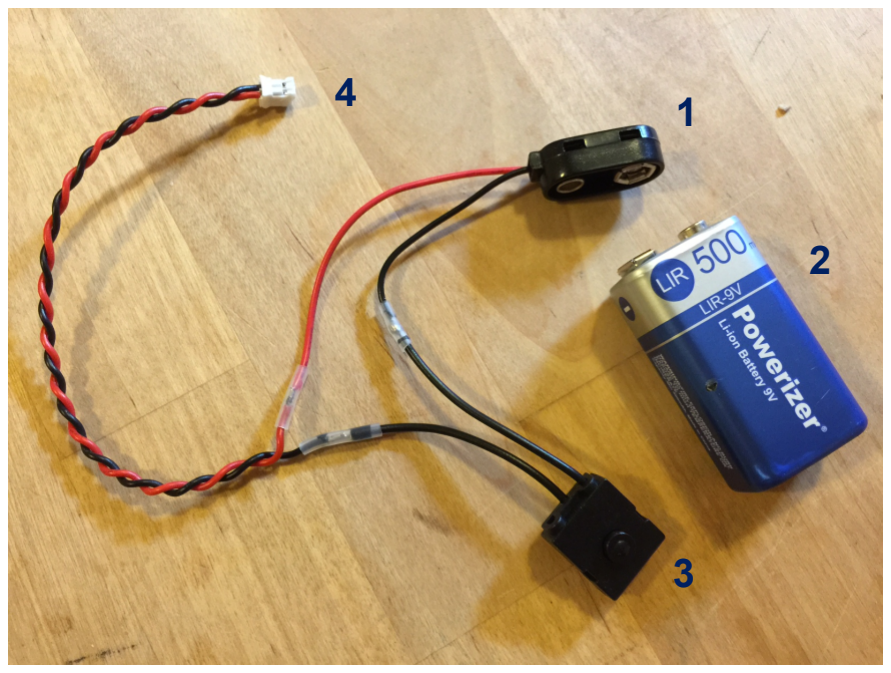
[picture p57: figure]

The power supply also includes a plug that connects to the buoyancy engine controller by sliding into the power supply jack on controller’s circuit board.

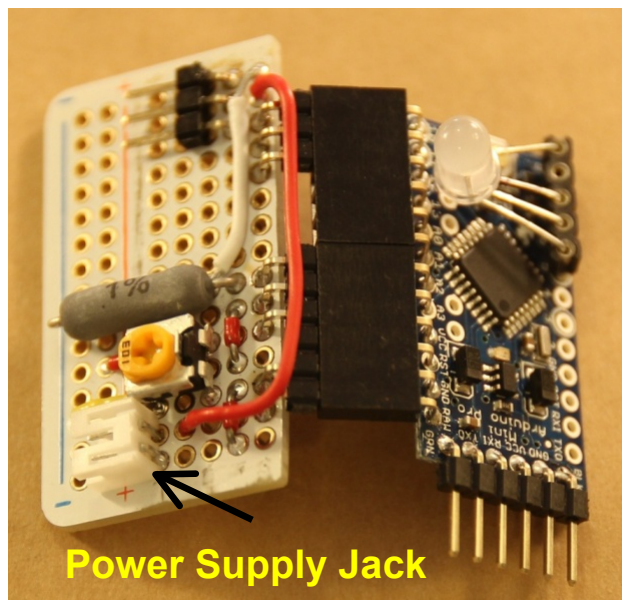
[picture p58: figure]
Power Supply Jack

The main components of the power supply are:

1. 9 VOLT SNAP CONNECTOR – Connects battery to power supply circuit.
2. LITHIUM BATTERY – Provides 9 volts of rechargeable power.
3. PUSH BUTTON SWITCH – The ON/OFF control for the circuit.
4. POWER SUPPLY PLUG – Provides power to the buoyancy engine controller by plugging into power supply jack.

To solder together the power supply, follow the instructions below.

Buoyancy Engine Controller

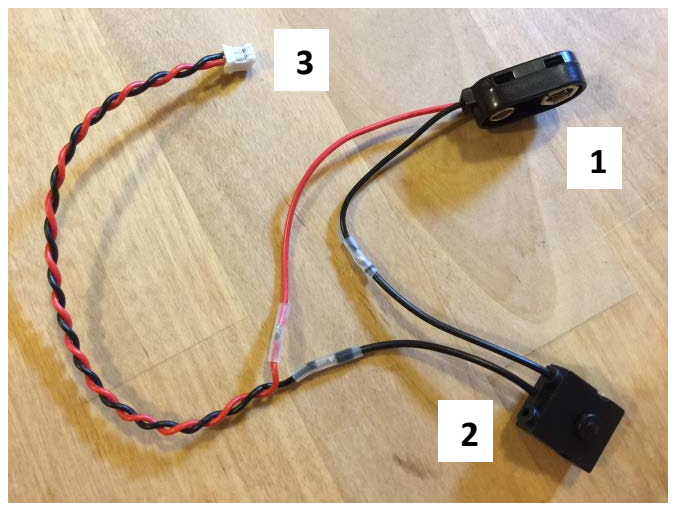
[picture p59: figure]

1. The circuit includes a 9 volt snap connector (1), pushbutton switch (2), and a power supply plug (3).

## Power Supply Build

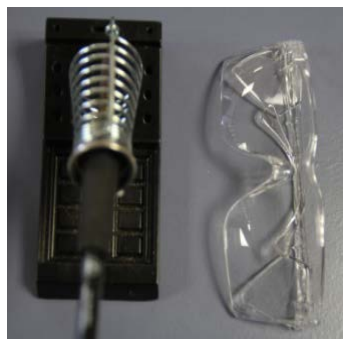
[picture p60: figure]
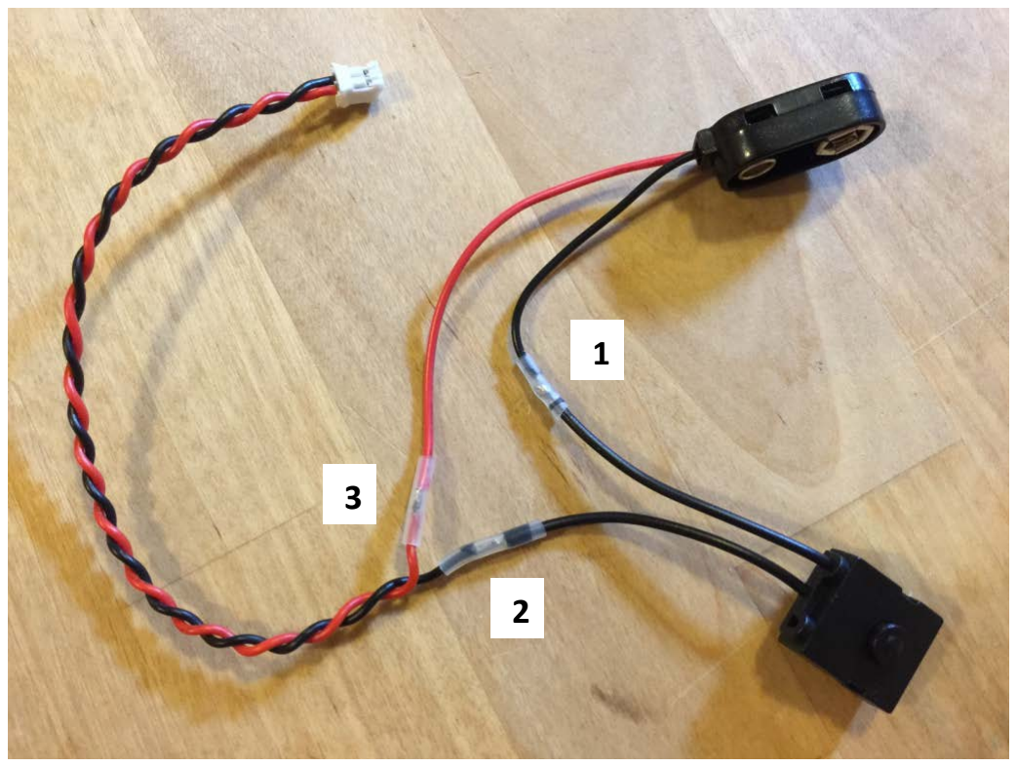
[picture p61: figure]

There are three solder joints that need to be protected with shrink tubing:
1. Black wire of snap connector to black wire of pushbutton.
2. Black wire of pushbutton to black wire of plug pigtail.
3. Red wire of plug pigtail to red wire of snap connector.

Safety Goggles Required

Power Supply Circuit

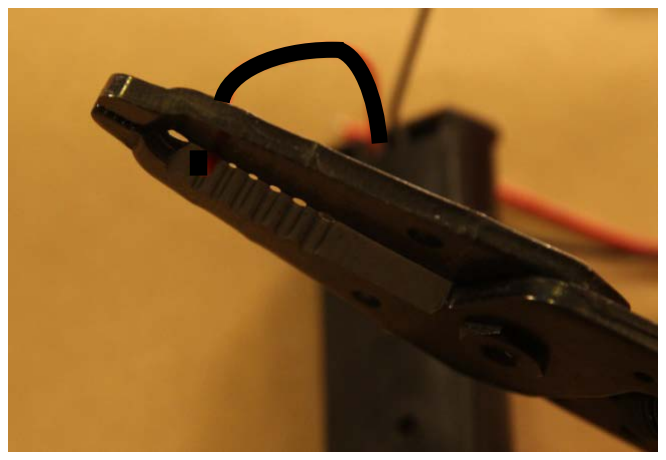
[picture p62: figure]

2. General soldering instructions for connecting two wires: Strip approximately ¼” of plastic insulation from wires to expose metal strands.

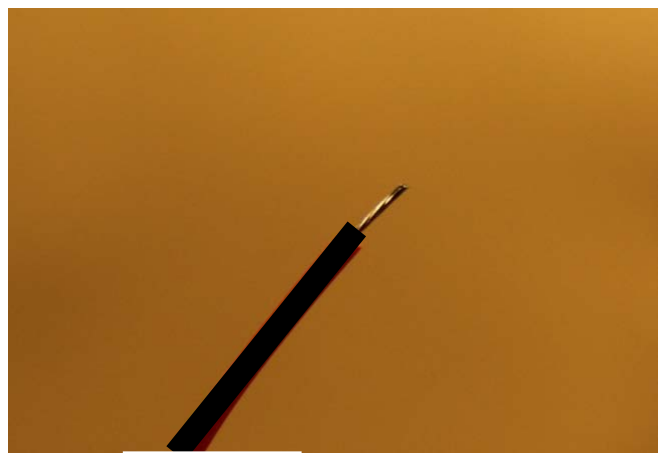
[picture p63: figure]

3. Expose metal strands.

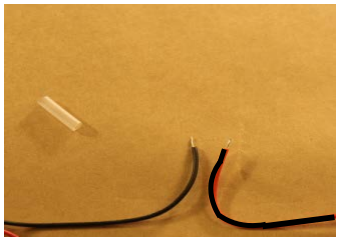
[picture p64: figure]

4. Cut a 3/8” length of heat shrink tubing.

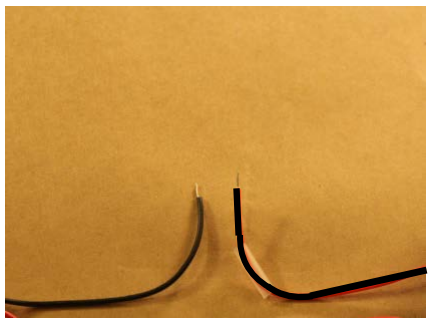
[picture p65: figure]

5. Place heat shrink tubing over one wire before twisting wires together and soldering.

6. Twist wires together.

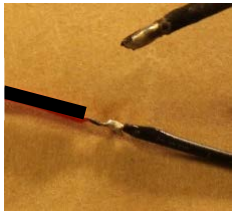
[picture p66: figure]

7. Solder joint. (Hot solder burns!)

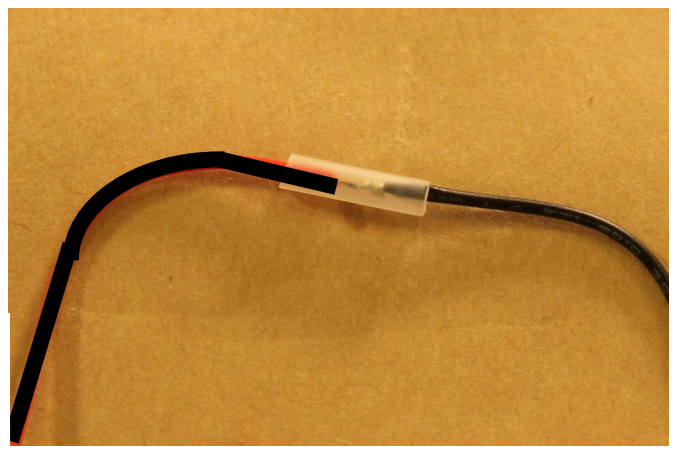
[picture p67: figure]

8. Slide heat shrink tubing over soldered joint.

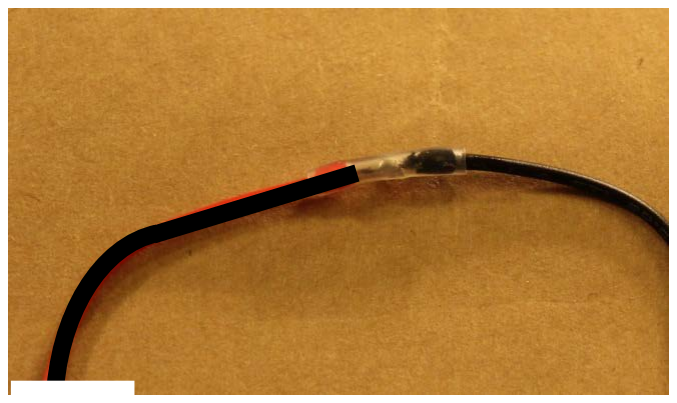
[picture p68: figure]

9. Carefully use heat gun to shrink tubing over joint to add strain relief and prevent exposed metal surface from shorting the circuit (electrical insulation).

Repeat the procedure above for the other two solder joints.

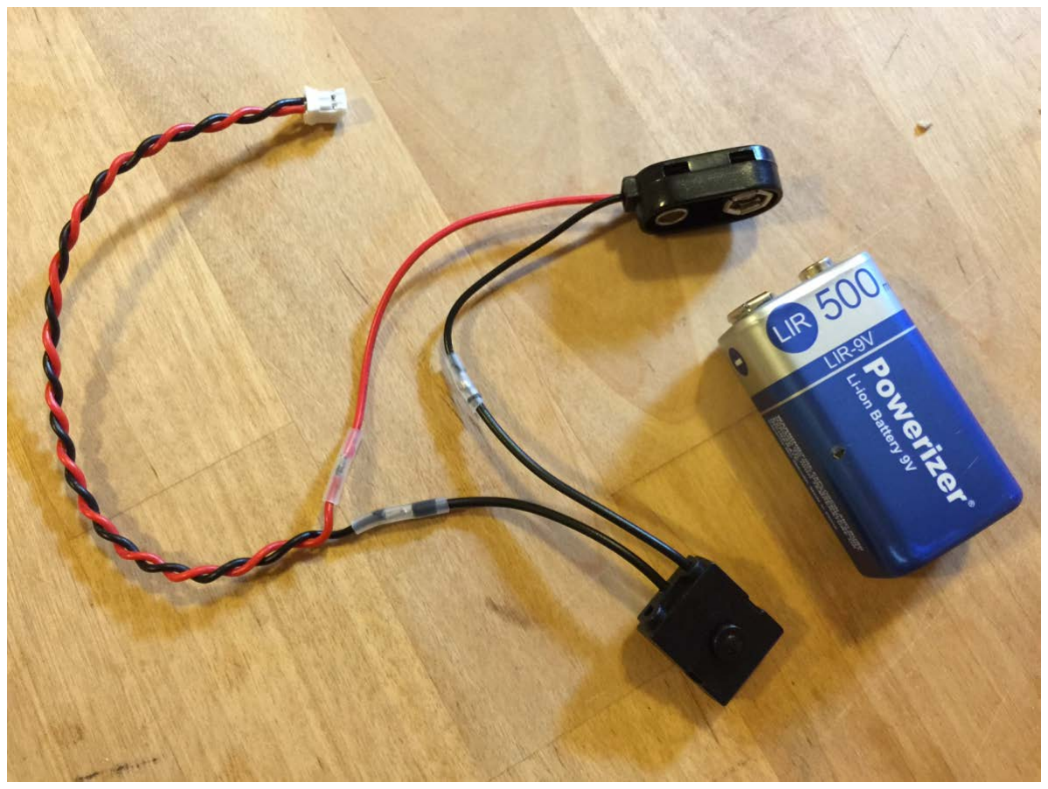
[picture p69: figure]

Looks good! More work ahead

You may charger you battery with the approved Smart Charger. Read and follow the Operating and Safety Instructions provided with the charger.

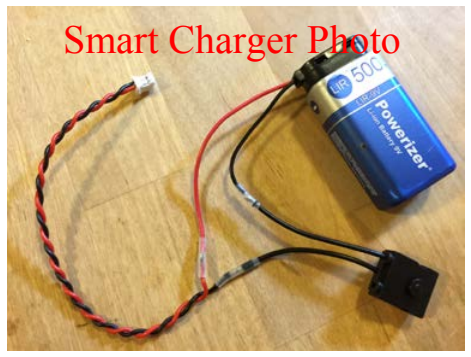
[picture p70: figure]
Smart Charger Photo

When charged set the battery aside for later use testing the Buoyancy Engine.

Power Supply Circuit with 9 Volt Lithium Rechargeable Battery

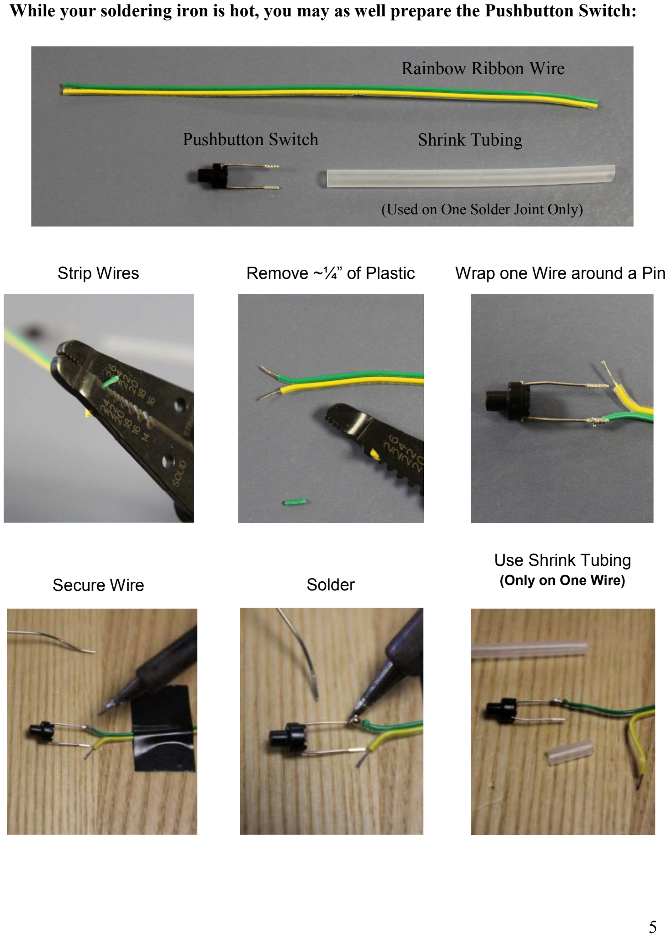
[picture p71: page 6]

Rainbow Ribbon Wire

Pushbutton Switch | Shrink Tubing
Strip Wires | Remove ~¼” of Plastic | Wrap one Wire around a Pin

Solder

Use Shrink Tubing
(Only on One Wire)

While your soldering iron is hot, you may as well prepare the Pushbutton Switch:

Secure Wire

(Used on One Solder Joint Only)

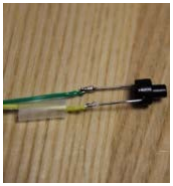
[picture p72: figure]
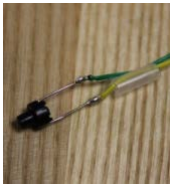
[picture p73: figure]

Wrap Wire around Pin

Save the Wired Pushbutton Switch for the Buoyancy Engine Build

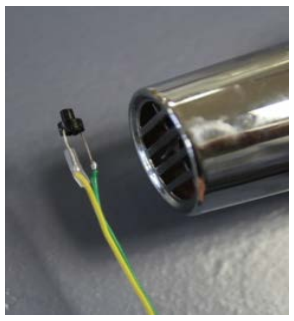
[picture p74: figure]

Solder | Position Tubing and Shrink

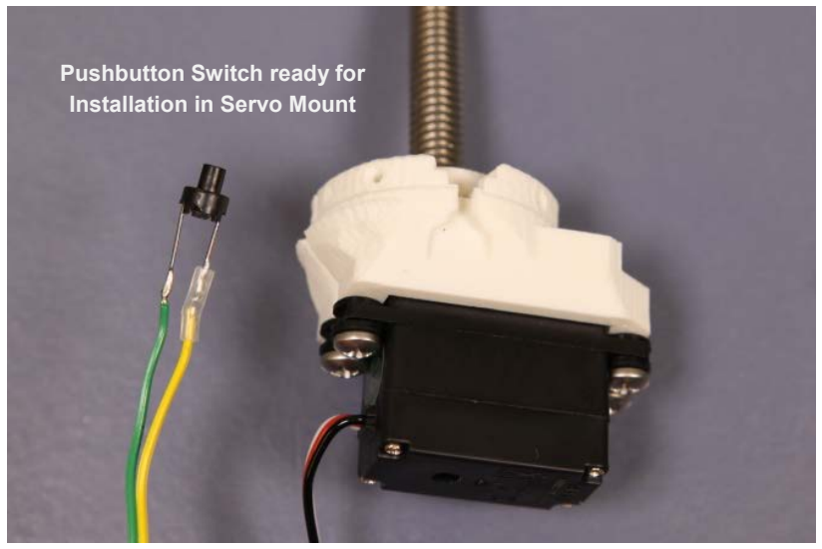
[picture p75: figure]
Pushbutton Switch ready for Installation in Servo Mount

The pushbutton switch will act as a “limit” switch in the buoyancy engine to prevent moving mass/plunger from crashing into and stalling the servo. It provides a reliable position at which the mass/plunger will change direction. You’ll see.
