SeaGlide/Test/Build Instructions/6- Controller Final Preparations.pdf

# BE Controller Final Preparations

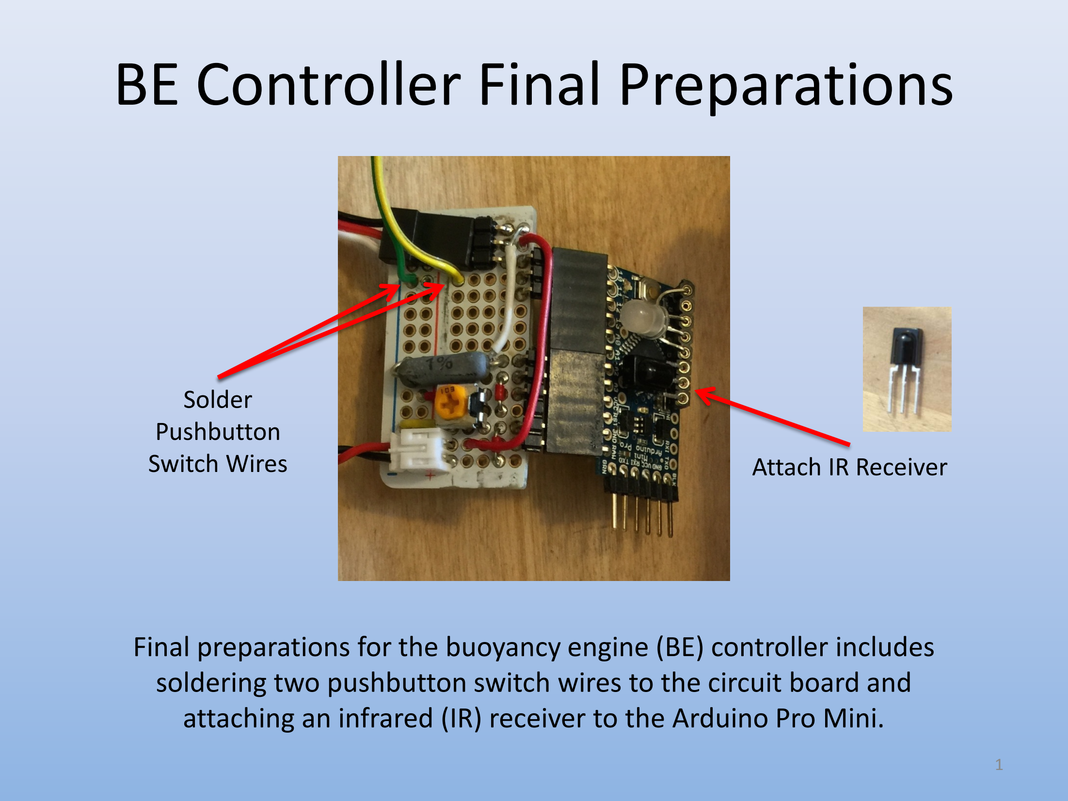
[picture p111: page 1]

Final preparations for the buoyancy engine (BE) controller includes soldering two pushbutton switch wires to the circuit board and attaching an infrared (IR) receiver to the Arduino Pro Mini.

Solder
Pushbutton
Switch Wires | Attach IR Receiver

## Connect Pushbutton Switch Wires to Circuit Board

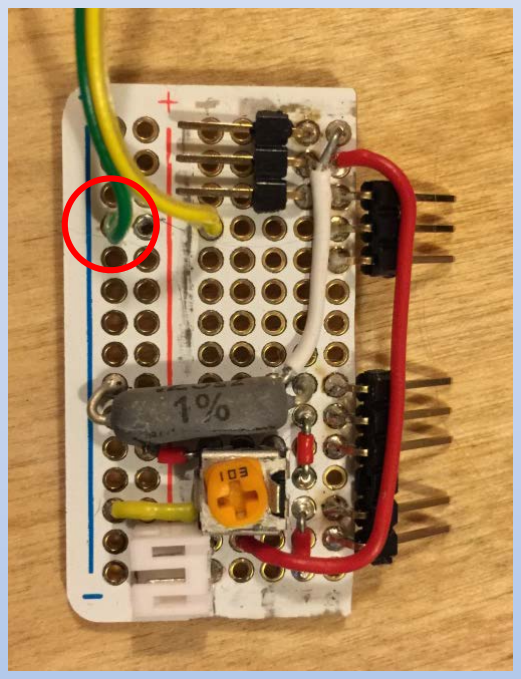
[picture p112: figure]

Solder one pushbutton
switch wire to the
ground rail.

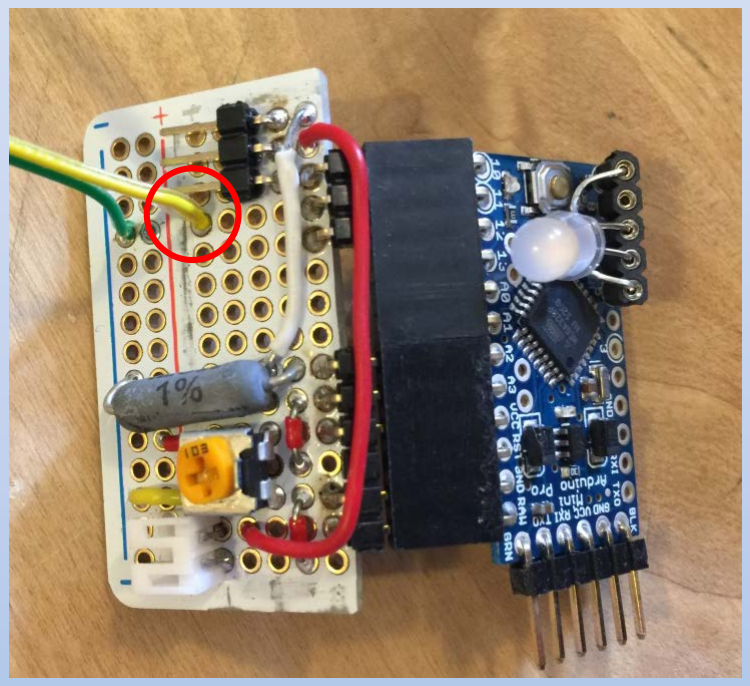
[picture p113: figure]

Solder the other to row 4
across from Pin 11 on the
Arduino Pro Mini.

## Buoyancy Engine with Pushbutton Switch Wires Attached to Controller

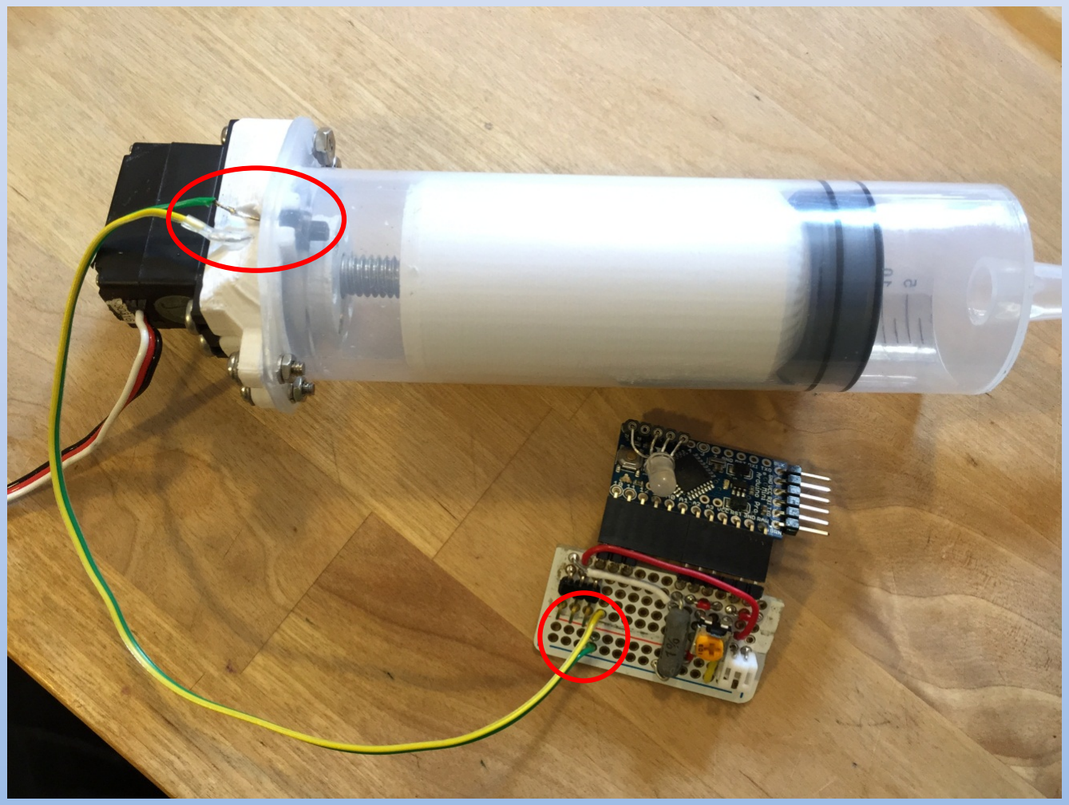
[picture p114: figure]

## Locate IR Receiver and Socket Pins

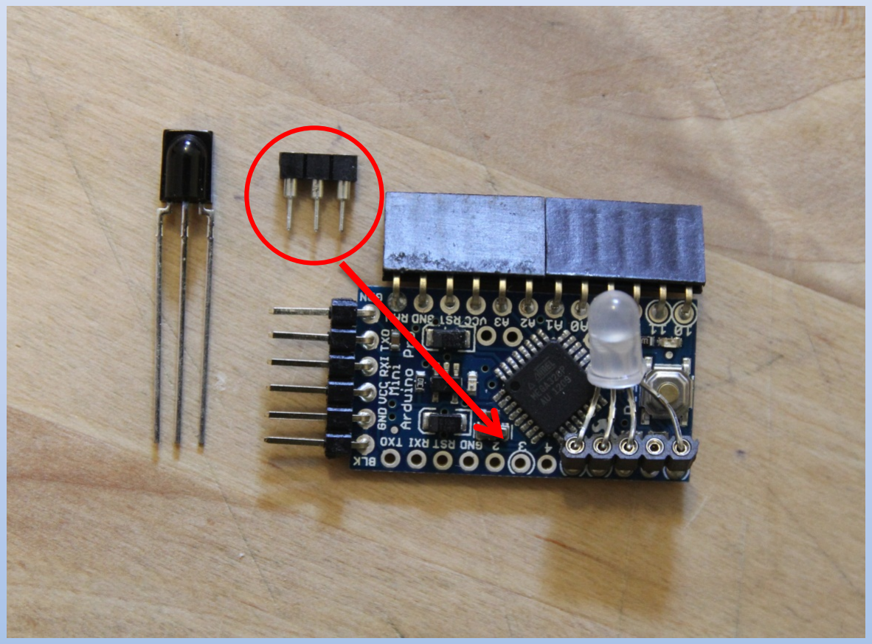
[picture p115: figure]

The set of three socket pins will be soldered next to the LED socket pins at a similar angle.

## Solder Socket Pins on Arduino Board

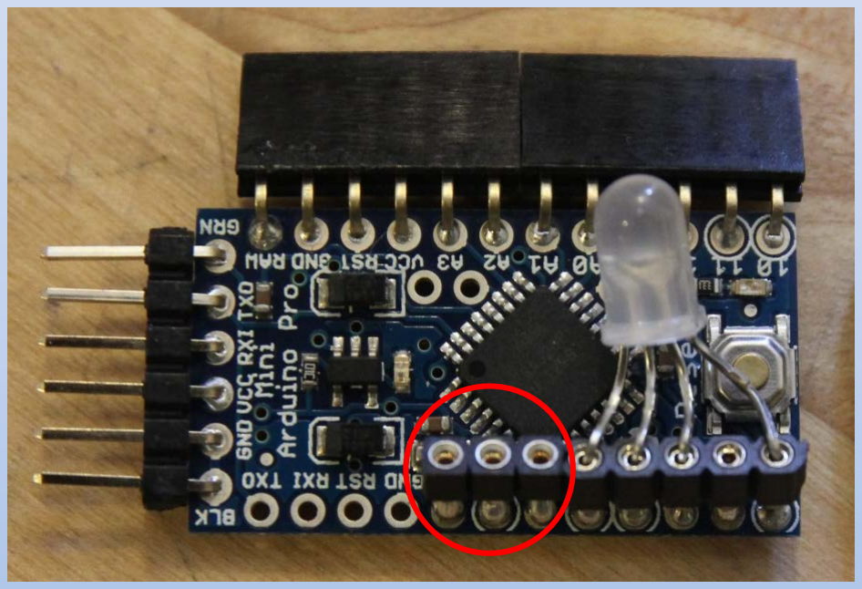
[picture p116: figure]

Make sure the angle of the socket pin set tilts in and matches that of the socket LED pins.

## Shorten IR Receiver Pins and Position on Board

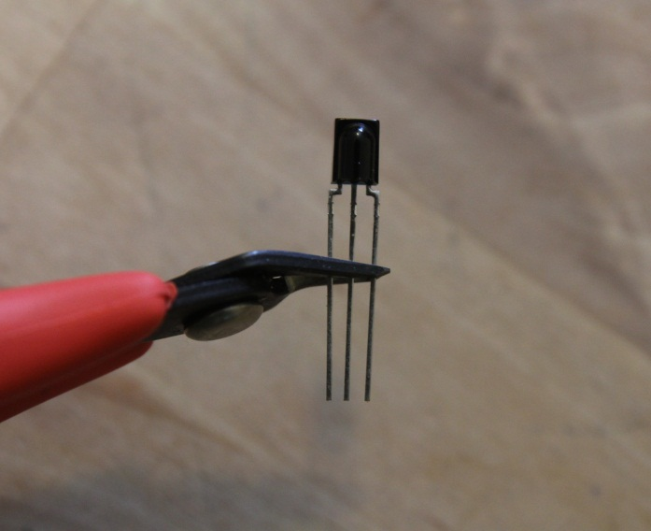
[picture p117: figure]

Cut IR receiver pin length approximately in half.

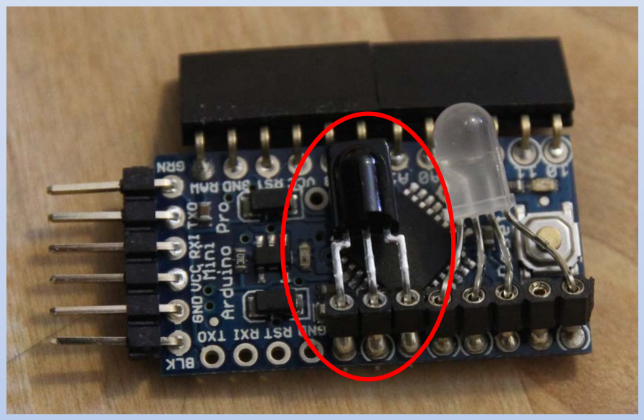
[picture p118: figure]

Insert IR receiver into the sockets. Bend it down to reduce its profile.

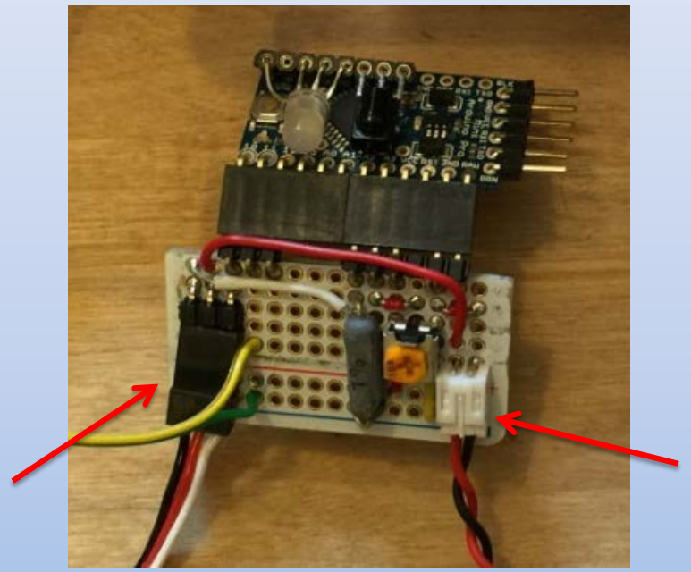
[picture p119: figure]

Join the Arduino Pro Mini to the circuit board and then connect the power supply and servo as described above. Make sure you lineup the white wire in the servo connector with pin 10 on the Arduino.

### Connect Power Supply and Servo to Circuit Board

Slide servo
connector into right
angle header pins.
(Note wire order.)

Slide power supply
plug into power
supply jack.

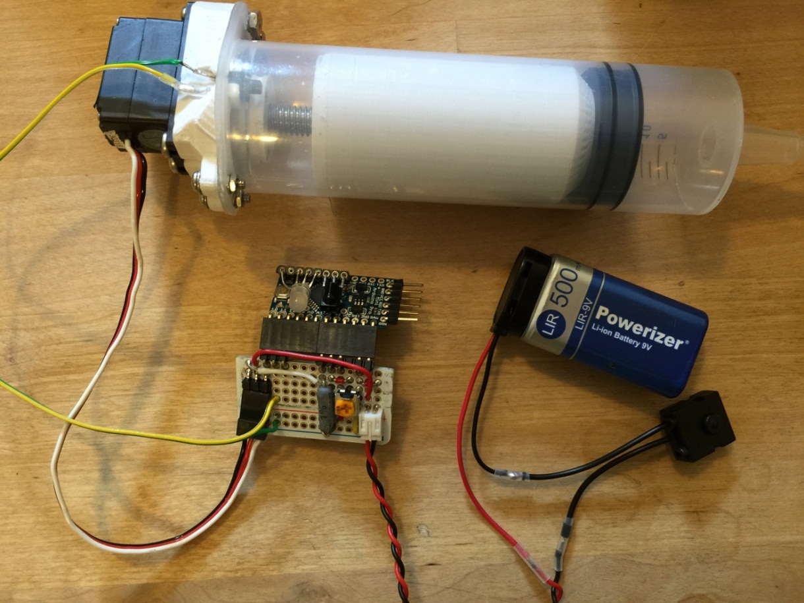
[picture p120: figure]

Make sure that the controller and power supply circuits have been tested separately then test the whole system with the buoyancy engine.

## Completed Buoyancy Engine System with Controller and Power Supply

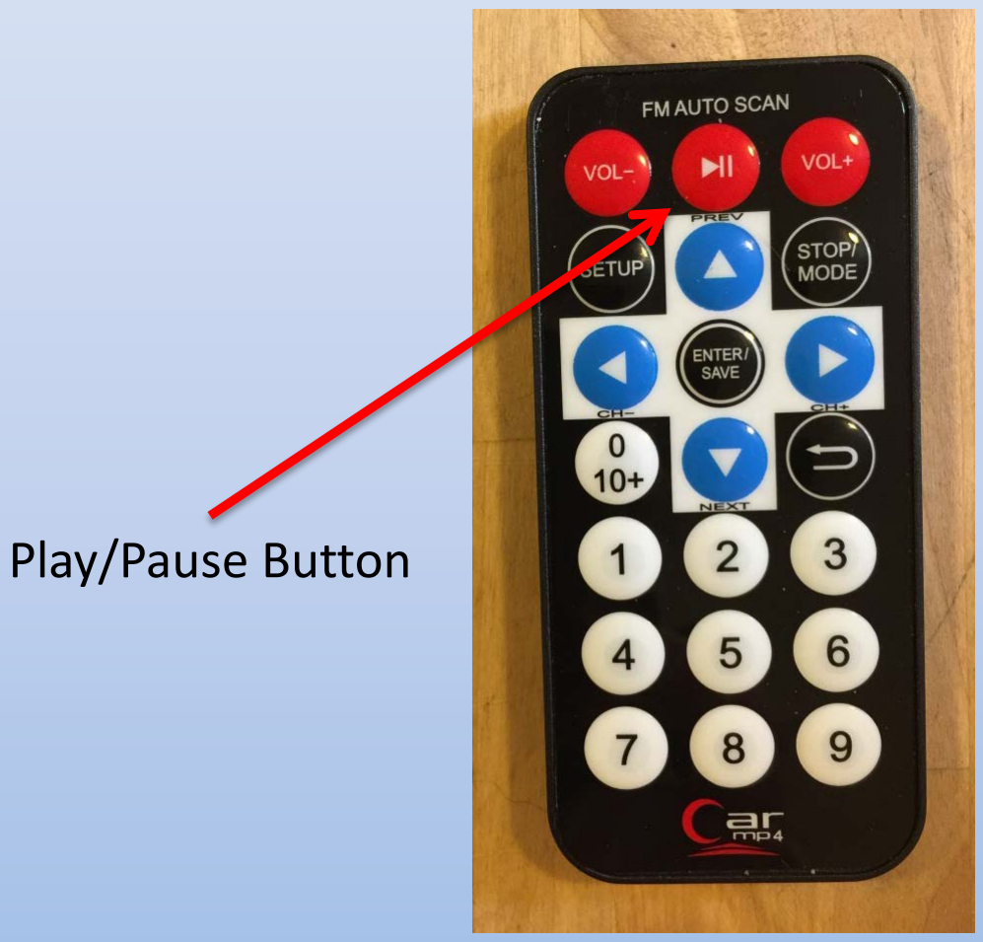
[picture p121: figure]
Play/Pause Button

The Play/Pause button on the remote should be able to stop and start the buoyancy engine once it is started with the manual switch.

# Test the Infrared Remote’s Operation
