SeaGlide/Test/Build Instructions/8- Buoyancy Engine Final Preparations.pdf

## Buoyancy Engine Final Preparations

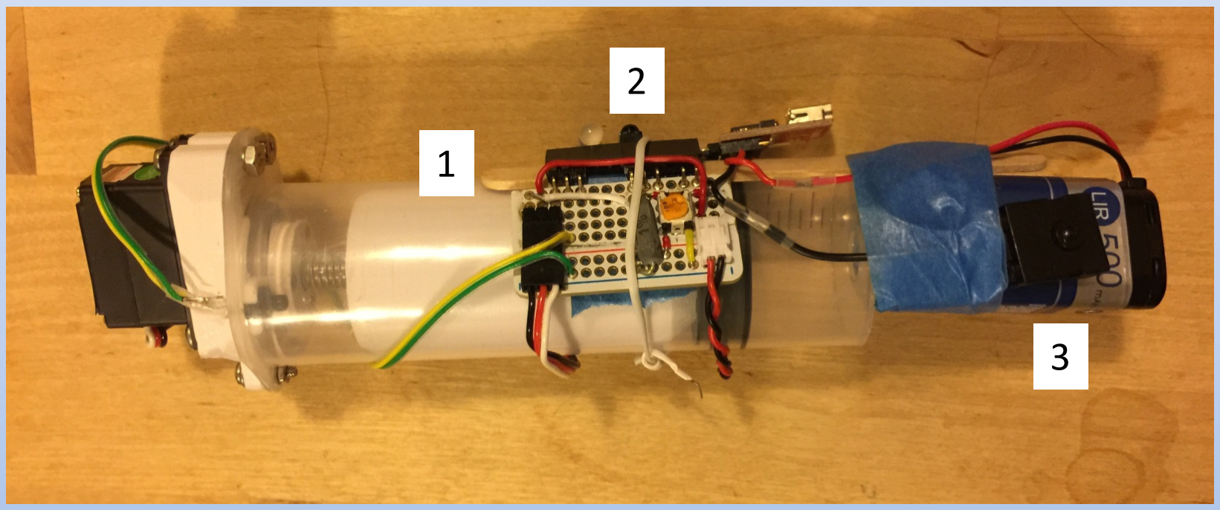
[picture p122: figure]

Final preparations include attaching a Popsicle stick support (1), buoyancy engine controller (2), and power supply(3) to the buoyancy engine.

## Attach Popsicle Stick and Controller

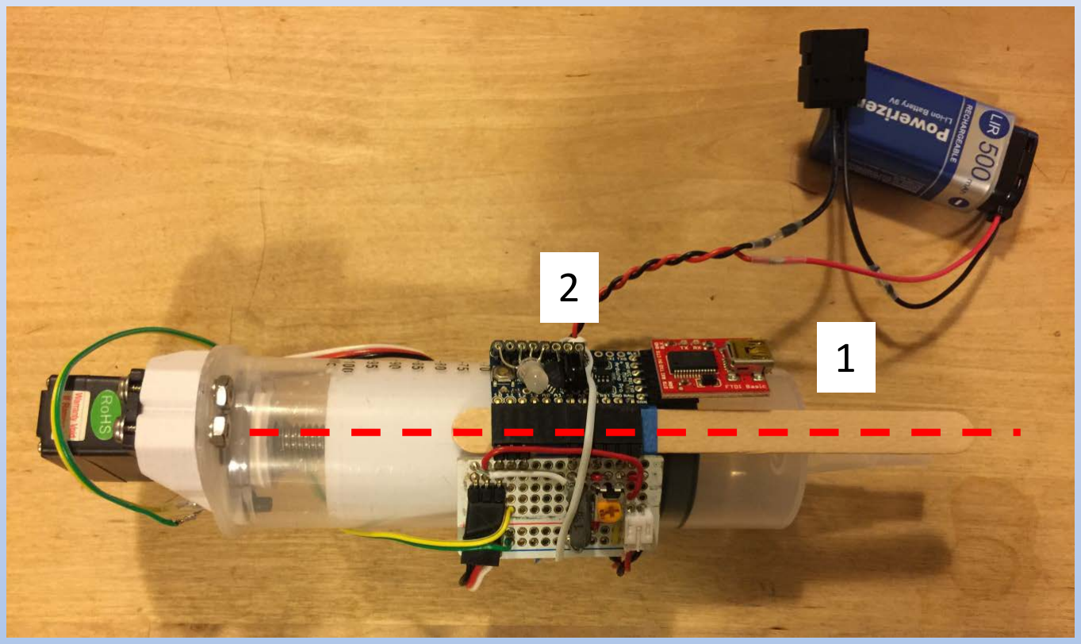
[picture p123: figure]

Use tape to attach Popsicle stick in line with extended (tall) flange end of syringe and the syringe tip (1). (The stick should not extend beyond the end of the tip.) Use a twist tie to attached the controller on top of the Popsicle stick in the middle of the syringe (2).

## Side View of Popsicle Stick and Controller Secured to Syringe

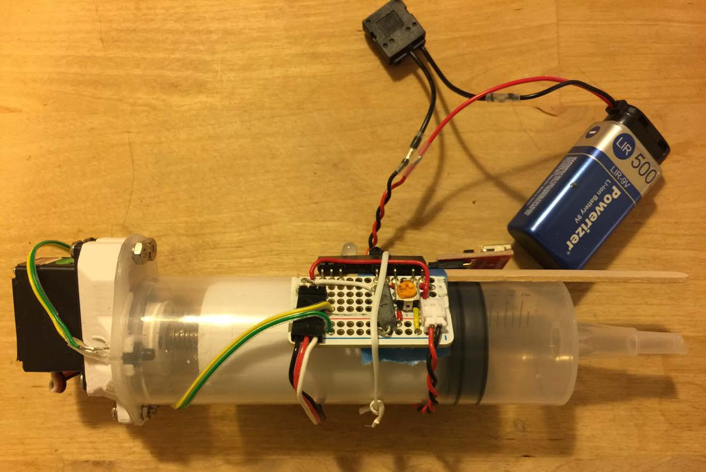
[picture p124: figure]

The Popsicle stick will support the power supply at the tip end of the syringe.

## Connect Syringe to Bottle Cap

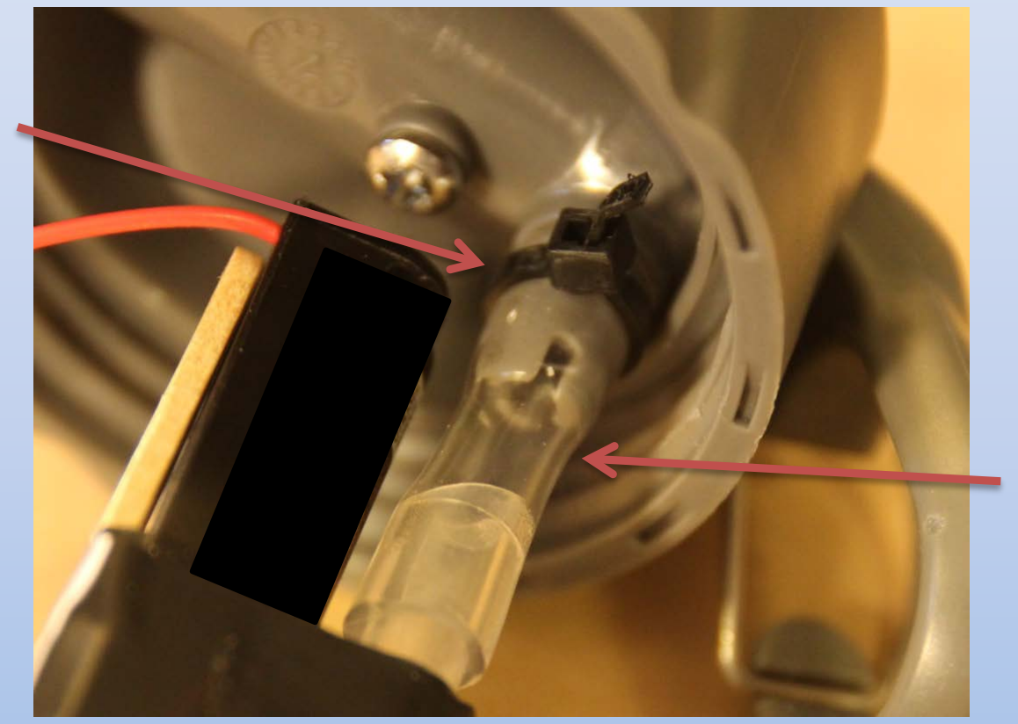
[picture p125: figure]

Use clear tubing to connect the syringe tip to cap’s interior nozzle. Secure the connection with a zip tie.

Zip Tie

Clear Tubing

# Attach the Battery with Switch

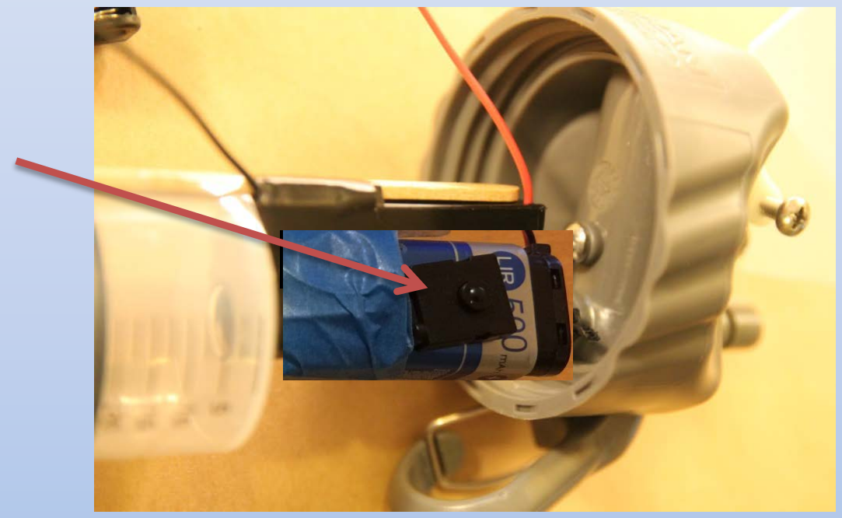
[picture p126: figure]
Battery

Attach the battery with ON/OFF switch between the Popsicle stick and the syringe tip. Make sure the switch is exposed for easy access and that the threads on the inside of the cap are free of any obstructions.

Pushbutton
ON/OFF
Switch

## Test Fit

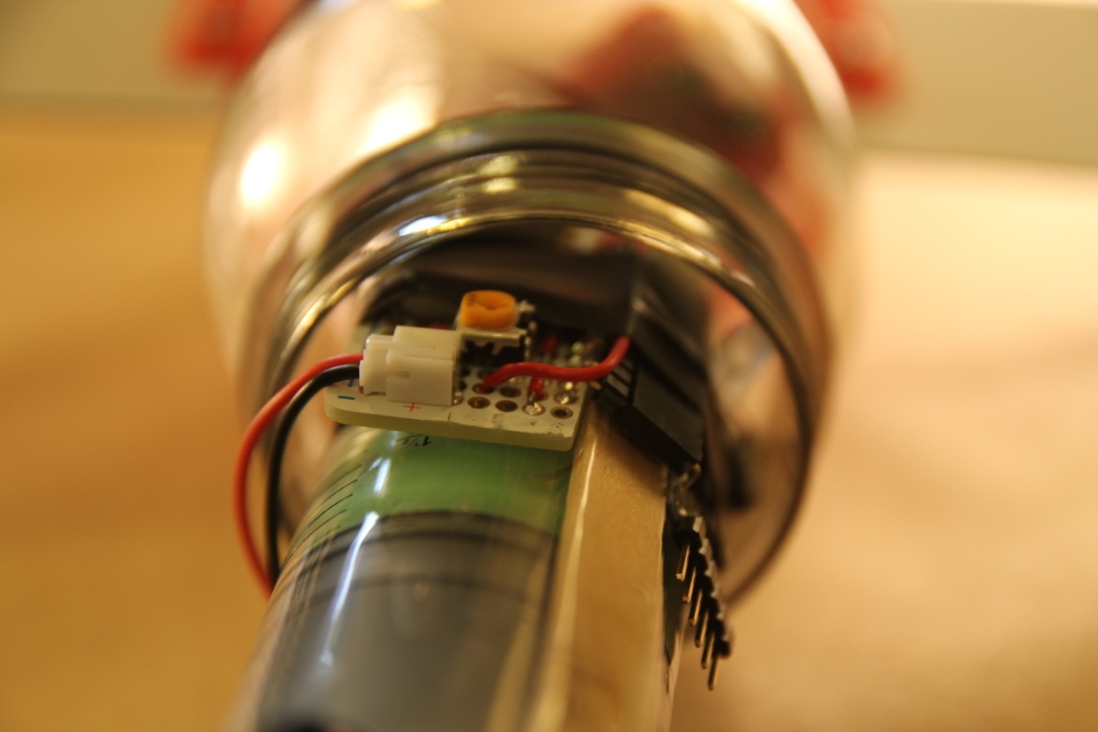
[picture p127: figure]

Test fit the buoyancy engine with controller and power supply through the mouth of bottle.
