SeaGlide/Test/Build Instructions/9- Underwater Flight Final Preparations.pdf

## Underwater Flight – Final Preparations

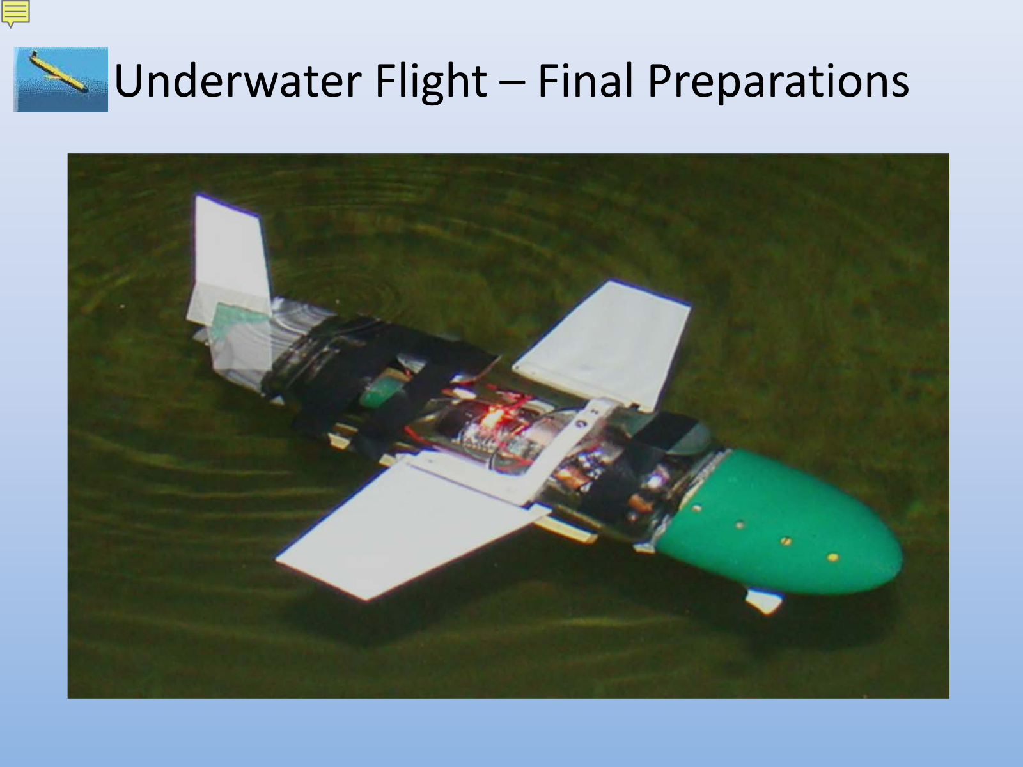
[picture p128: page 1]

## After Testing - Fit BE into Bottle

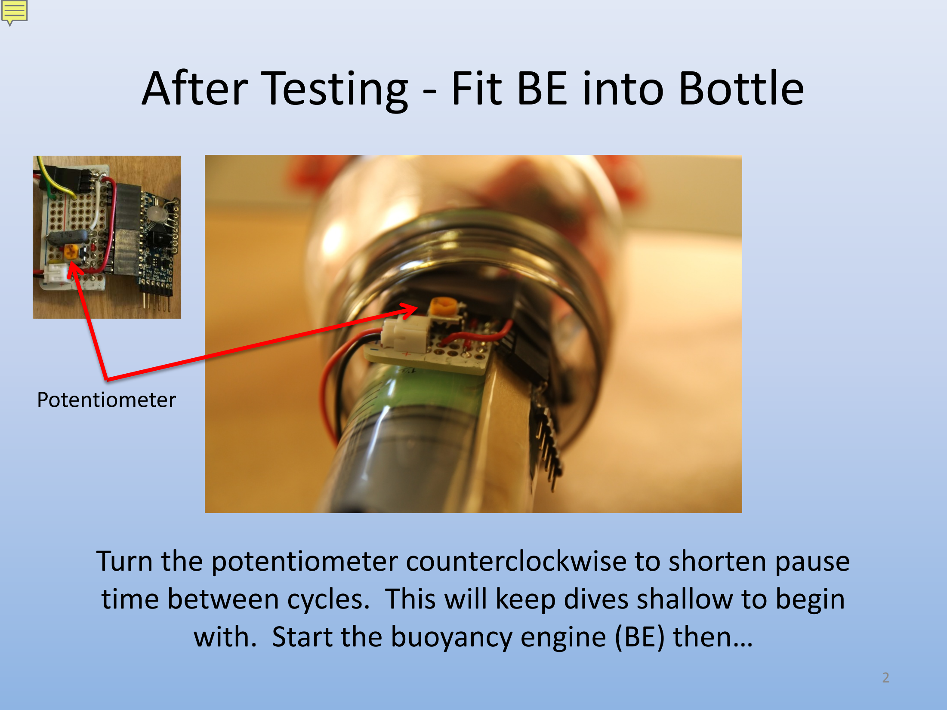
[picture p129: page 2]

Turn the potentiometer counterclockwise to shorten pause time between cycles. This will keep dives shallow to begin with. Start the buoyancy engine (BE) then…

2

Potentiometer

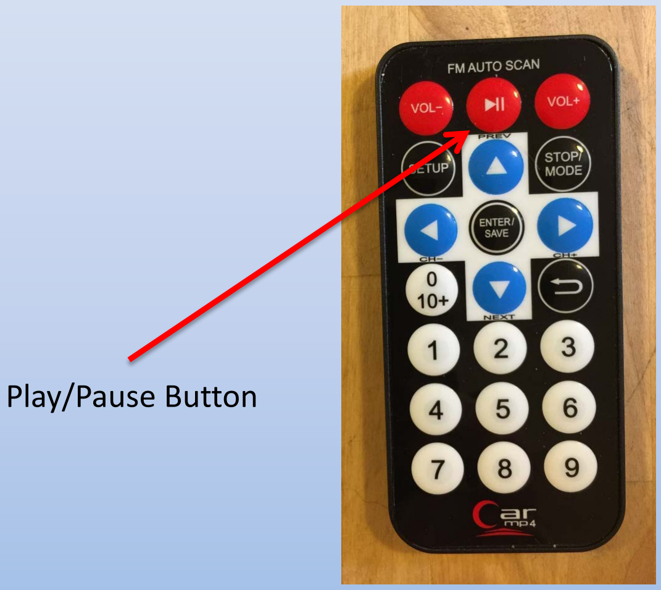
[picture p130: figure]
Play/Pause Button

Use the remote’s Play/Pause button to pause the buoyancy engine.

# Use Remote to Pause BE

3

# Seal Bottle

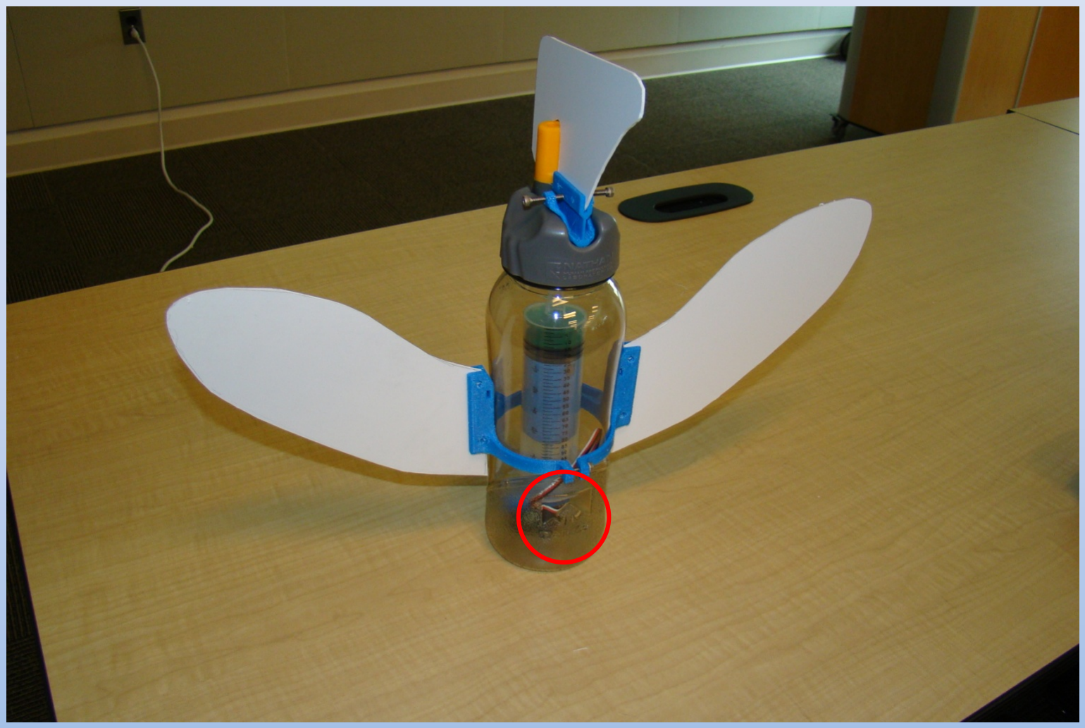
[picture p131: figure]

With the bottle upright on a table, slide in the buoyancy engine. Tighten the cap. The rudder should align with the Nathan icon (circled) and be perpendicular to the wings.

## Burping the Bottle

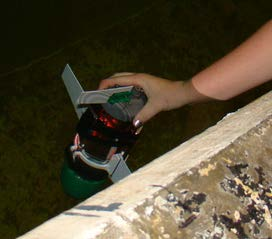
[picture p132: figure]

Start the buoyancy engine and hold the glider underwater for at least two cycles to expel any excess air in the syringe.

# Use Remote to Center Plunger

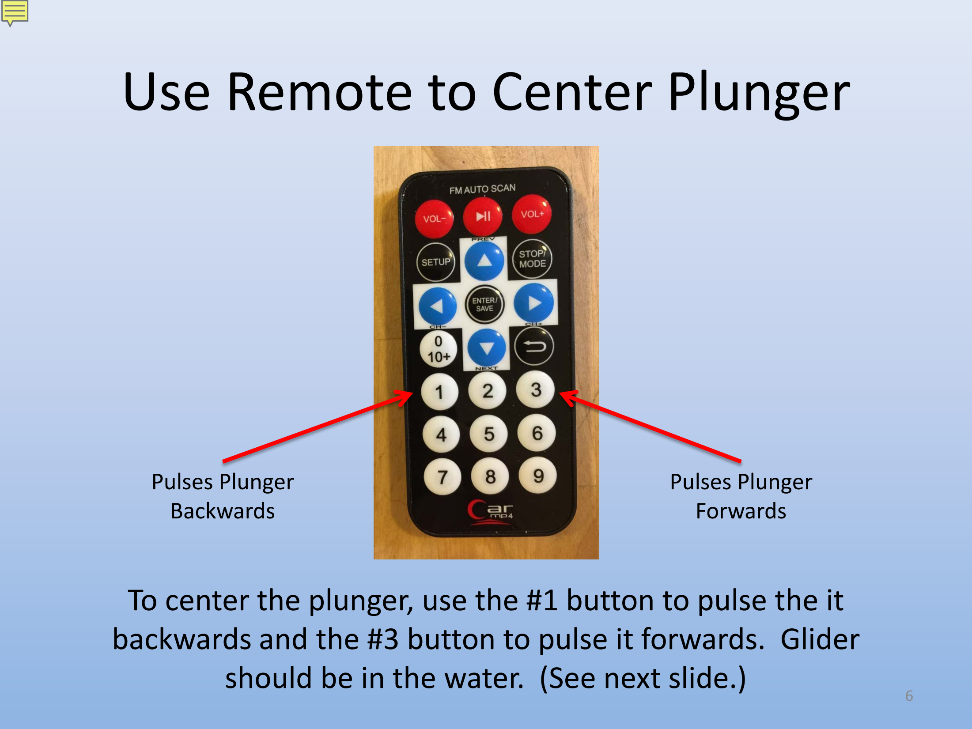
[picture p133: page 6]

To center the plunger, use the #1 button to pulse the it backwards and the #3 button to pulse it forwards. Glider should be in the water. (See next slide.)

Pulses Plunger
Backwards

6

Pulses Plunger
Forwards

# Glider in Balance at Surface Balance Glider Pitch

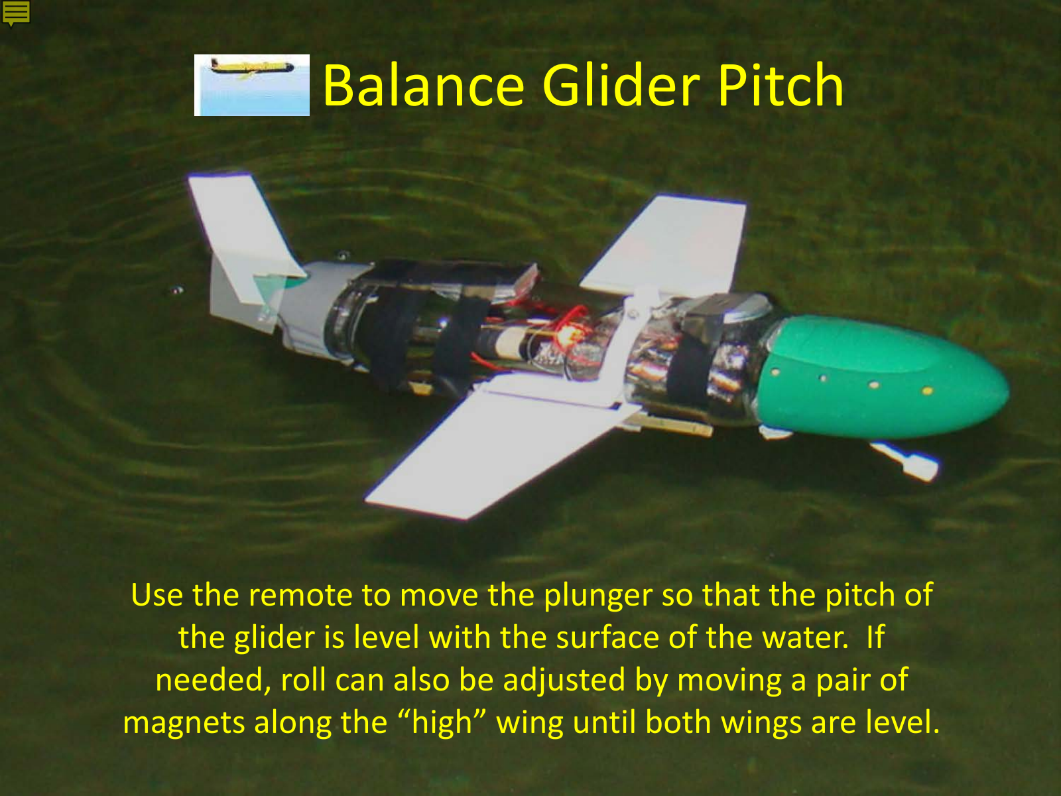
[picture p134: page 7]

Use the remote to move the plunger so that the pitch of the glider is level with the surface of the water. If needed, roll can also be adjusted by moving a pair of magnets along the “high” wing until both wings are level.

## When Things Look Good, Let Her Go!

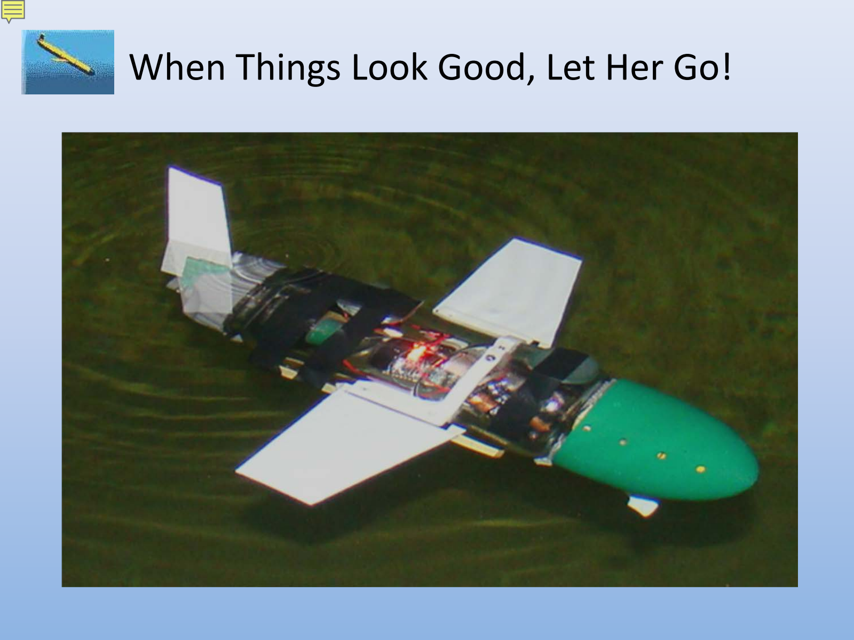
[picture p135: page 8]

## Your Glider should Dive and Surface in a Smooth Cycle

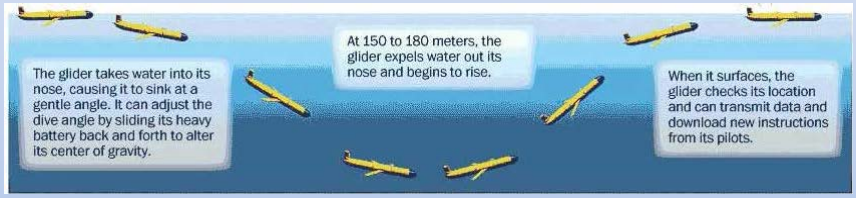
[picture p136: figure]
