SeaGlide/Test/Build Instructions/4- Printed Circuit Boar.pdf

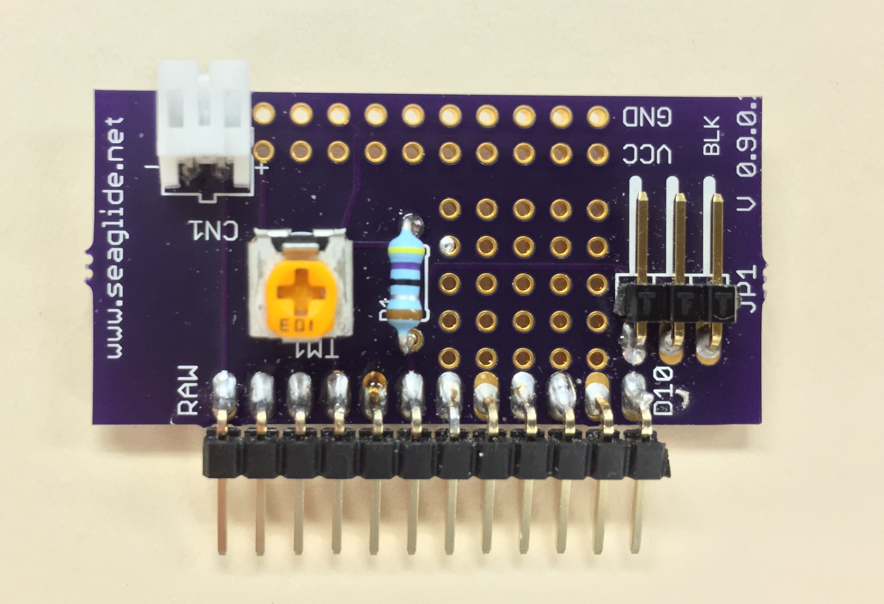
[picture p137: page 1]
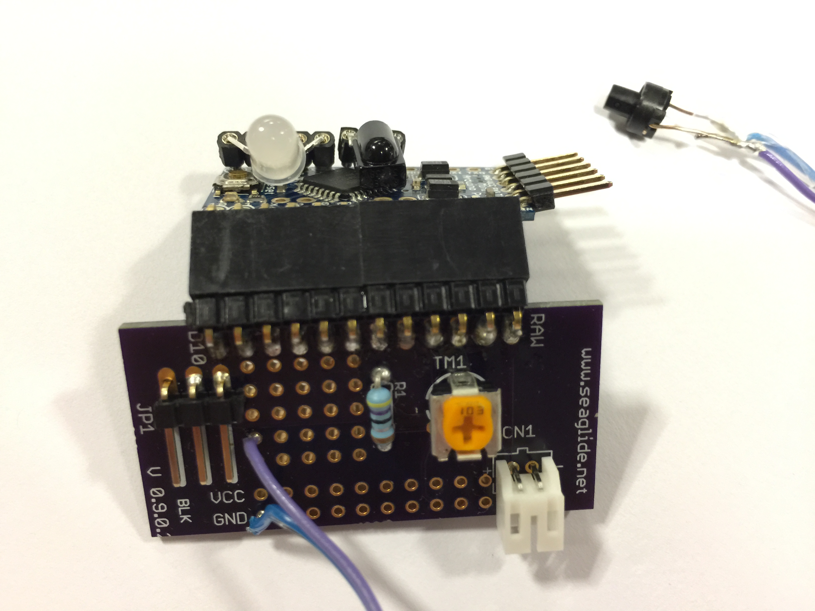
[picture p138: page 2]
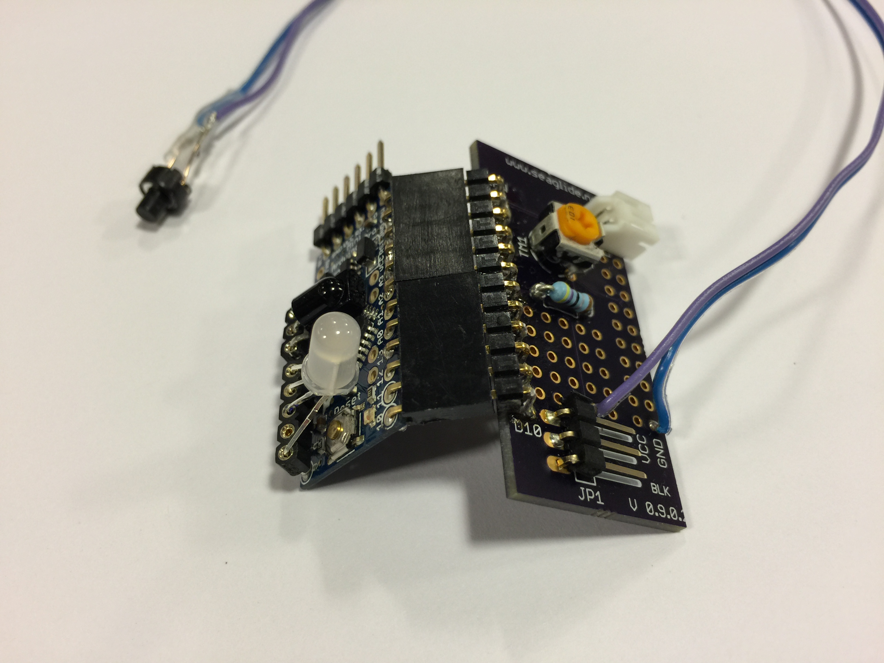
[picture p139: page 3]
