SeaGlide/Test/Lessons/11- Pressure&TemperatureGraphs.pdf

# Pressure PSI and Temperature Degrees F From 0 to 2 feet depth in Mini Model Basin

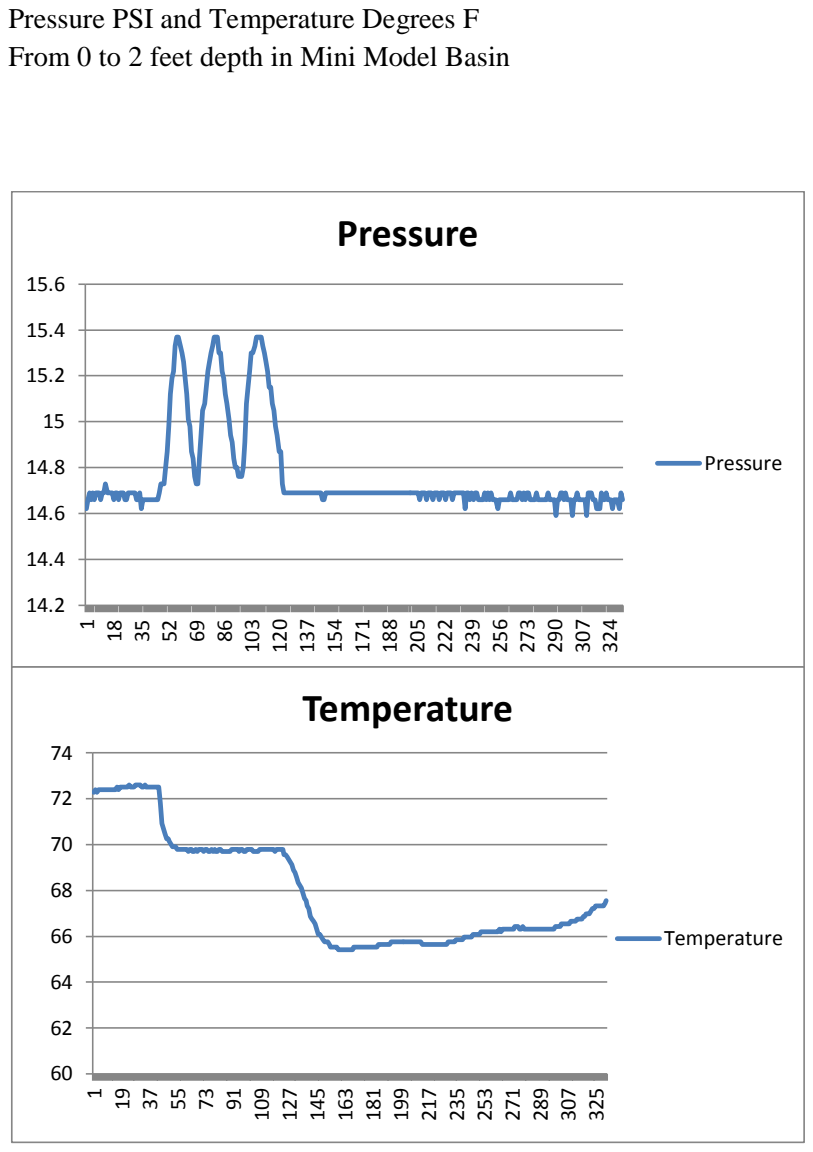
[picture p173: page 1]
Pressure; Temperature
