SeaGlide/Test/(list of files, drawings)

Other design files:
Lessons/Arduino lessons/Fritzing Circuits/1 Blink.fzz
Lessons/Arduino lessons/Fritzing Circuits/2 Potentiometer.fzz
Lessons/Arduino lessons/Fritzing Circuits/2.5 FlexSensor.fzz
Lessons/Arduino lessons/Fritzing Circuits/2.5 PhotoResistor.fzz
Lessons/Arduino lessons/Fritzing Circuits/3 button PullUp.fzz
Lessons/Arduino lessons/Fritzing Circuits/3 button.fzz
Lessons/Arduino lessons/Fritzing Circuits/4 Button Servo .fzz
Lessons/Arduino lessons/Fritzing Circuits/4.1 PotFadeSerialServo .fzz
